tait-mx/Constelacion/Electronica/DFPlayer mp3/conexiones amazon.jpg

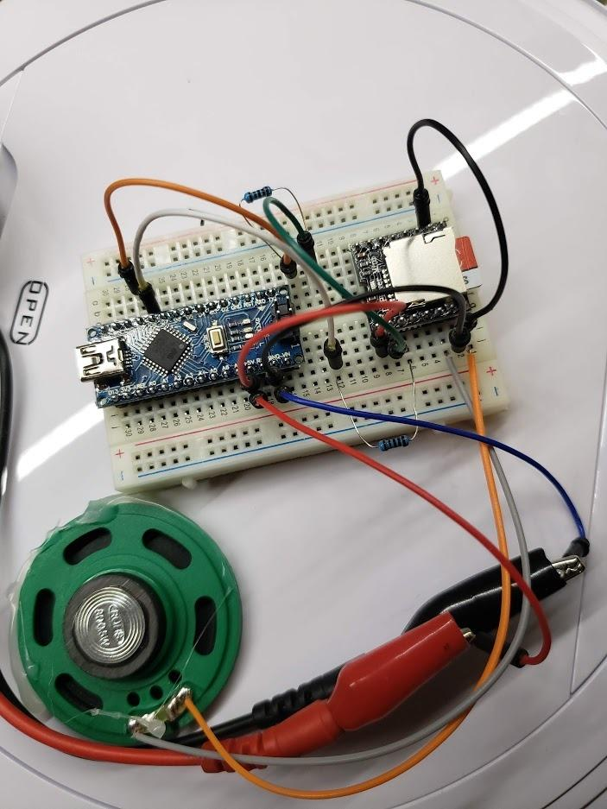
Electronica/DFPlayer mp3/conexiones amazon.jpg
