tait-mx/Constelacion/Electronica/DFPlayer mp3/Avoid Noise Add 10kohm to Tx Rx.png

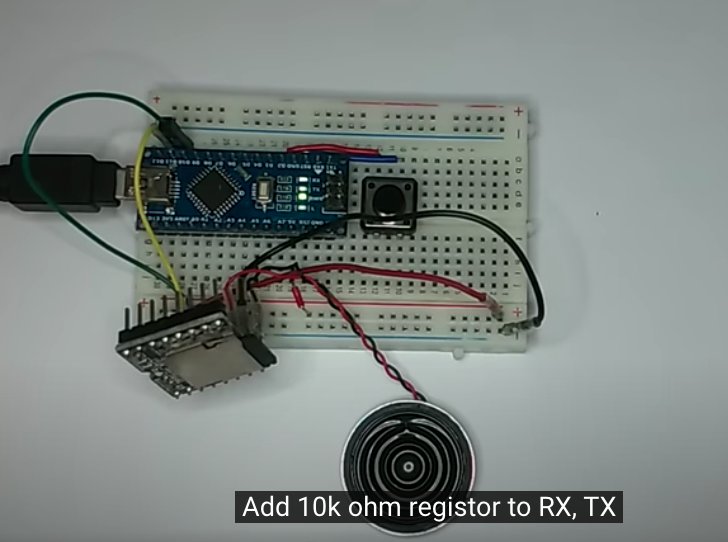
Electronica/DFPlayer mp3/Avoid Noise Add 10kohm to Tx Rx.png
