tait-mx/Constelacion/ESP32/ESP32-C3_SuperMini_macOS_HighSierra_solucion.docx

Solución: Programar ESP32-C3 Super Mini desde macOS 10.13.6 (High Sierra)

Guía de pasos seguidos para resolver la incompatibilidad entre Arduino IDE 1.8.16, el core ESP32 moderno y macOS High Sierra.

# Resumen del problema

La placa ESP32-C3 Super Mini requiere una versión reciente del paquete (core) de ESP32 para Arduino, pero las versiones recientes de ese paquete incluyen un ejecutable de "esptool" compilado únicamente para macOS 10.15 (Catalina) o superior. En macOS 10.13.6 esto provoca errores de compilación y carga ("Symbol not found: ____chkstk_darwin"). Este es un problema reconocido oficialmente por Espressif (issue #5639 en su repositorio de GitHub), marcado como "no se va a corregir" porque sus sistemas de compilación ya no soportan versiones antiguas de macOS.

# Pasos realizados

## 1. Identificar la placa y el pinout correcto

Se confirmó que la placa correspondía a la variante ESP32-C3 Super Mini (chip QFN32 5x5mm), distinta del ESP32 DevKit clásico (módulo WROOM). El LED integrado en esta placa está conectado al GPIO8 y funciona con lógica invertida (LOW = encendido, HIGH = apagado).

## 2. Actualizar el paquete de placas ESP32 en Arduino IDE

En Arduino > Preferences se verificó la URL adicional de gestor de placas:

https://raw.githubusercontent.com/espressif/arduino-esp32/gh-pages/package_esp32_index.json

Luego, desde Herramientas > Placa > Boards Manager, se actualizó el paquete "esp32" de Espressif Systems para que apareciera la opción "ESP32C3 Dev Module".

## 3. Resolver error de descarga corrupta (CRC doesn't match)

Al actualizar el paquete apareció un error de CRC por una descarga incompleta. Se solucionó borrando los archivos en caché dentro de:

~/Library/Arduino15/staging/packages

y reinstalando el paquete desde Boards Manager para forzar una descarga limpia.

## 4. Descartar Arduino IDE 2.x

Se confirmó que Arduino IDE 2.x requiere macOS 10.15 (Catalina) o superior, por lo que no es instalable en macOS 10.13.6. Se continuó trabajando con Arduino IDE 1.8.16, que sí es compatible.

## 5. Diagnosticar el error de Python/esptool

Al compilar para "ESP32C3 Dev Module" apareció el error:

Error loading Python lib '.../libpython3.8.dylib': ... Symbol not found: ____chkstk_darwin

Se identificó que este es un problema conocido y documentado (GitHub issue #5639 de espressif/arduino-esp32): el ejecutable "esptool" incluido en el paquete a partir de la versión 2.0.0 del core requiere macOS 10.15 o superior.

## 6. Instalar Python 3 y esptool

Se confirmó que la Mac ya tenía Python 3.7.5 instalado. Se instaló pyserial y, tras varios ajustes, se optó por una versión de esptool compatible con Python 3.7 sin dependencias pesadas (cryptography con Rust):

pip3 install --upgrade pip setuptools wheel

pip3 install pyserial "esptool==3.3.1"

Se verificó la instalación con:

esptool.py version → esptool.py v3.3.1

## 7. Editar platform.txt (primer intento — sufijo incorrecto)

Se localizó el archivo de configuración del core en:

~/Library/Arduino15/packages/esp32/hardware/esp32/<version>/platform.txt

Se agregó una línea para usar Python en lugar del binario roto, inicialmente con el sufijo "macos" (incorrecto):

tools.esptool_py.cmd.macos=python3 -m esptool

El error persistió porque Arduino usa el sufijo "macosx" (con "x"), no "macos", para identificar el sistema operativo.

## 8. Corregir el sufijo del sistema operativo

Se corrigió la línea a:

tools.esptool_py.cmd.macosx=python3 -m esptool

Sin embargo, surgió un nuevo error: Arduino concatena la ruta y el comando como una sola cadena ("{ruta}/{comando}"), por lo que no puede interpretar "python3 -m esptool" como programa + argumentos. El sistema intentaba ejecutar un archivo literal con ese texto completo como nombre, lo cual no existe.

## 9. Reemplazar el binario roto por un script wrapper

Se revirtió el cambio en platform.txt (para volver a usar el nombre genérico "esptool") y, en su lugar, se reemplazó el binario problemático directamente:

cd ~/Library/Arduino15/packages/esp32/tools/esptool_py/3.1.0/

mv esptool esptool.roto

printf '#!/bin/bash\nexec python3 -m esptool "$@"\n' > esptool

chmod +x esptool

## 10. Corregir la ruta de Python dentro del script

El script inicial falló porque Arduino ejecuta procesos con un PATH restringido que no incluye la carpeta de Python. Se obtuvo la ruta absoluta con:

which python3

y se editó el script para usar la ruta completa en lugar de solo "python3", por ejemplo:

exec /usr/local/bin/python3 -m esptool "$@"

## 11. Corregir el puerto serie (USB)

Tras lograr compilar exitosamente, apareció un error de puerto no encontrado (/dev/cu.SLAB_USBtoUART), causado por haber cambiado de entrada USB física. Se identificó el puerto correcto con:

ls /dev/cu.*

y se seleccionó el puerto adecuado en Herramientas > Puerto dentro de Arduino IDE.

## 12. Resultado final

Con todos los ajustes anteriores, el sketch Blink compiló y se cargó exitosamente en el ESP32-C3 Super Mini, confirmando el parpadeo del LED integrado (GPIO8).

# Resumen de archivos y cambios clave

- Paquete ESP32 actualizado vía Boards Manager en Arduino IDE 1.8.16.
- Python 3.7.5 + pyserial + esptool 3.3.1 instalados vía pip3.
- Binario original en tools/esptool_py/3.1.0/esptool respaldado como esptool.roto.
- Nuevo script esptool creado en esa misma carpeta, apuntando a la ruta absoluta de python3.
- Puerto USB verificado y seleccionado correctamente en Herramientas > Puerto.

# Notas para el futuro

1. Si se reinstala o actualiza el paquete ESP32, es probable que el binario "esptool" original vuelva a aparecer y haya que repetir el reemplazo por el script wrapper.
2. Si se cambia de puerto USB o de cable, verificar el puerto correcto con "ls /dev/cu.*" antes de subir un sketch.
3. Esta solución aplica en general a cualquier herramienta del core ESP32 que dependa de un binario compilado incompatible con macOS 10.13 (por ejemplo, versiones futuras de espota.py u otras herramientas), usando el mismo enfoque de script wrapper.
