tait-mx/Constelacion/Tlc5940NT/Funciones_JLCooper_ConstelacionTodos.rtf

(
~funcionControladorLEDsOn={
~led2=254;~led3=254;~led4=254;~led5=254;~led6=254;~led7=254;~led8=254;~led9=254;
~led10=254;~led11=254;~led12=254;~led13=254;~led14=254;~led15=254;~led16=254;~led17=254;
~led18=254;~led19=254;~led20=254;~led21=254;~led22=254;~led23=254;~led24=254;~led25=254;
~led26=254;~led27=254;~led28=254;~led29=254;~led30=254;~led31=254;~led32=254;~led33=254;}
);
/*
~funcionControladorLEDsOn.value
*/
(
~funcionControladorLEDsOff={
~led2=0;~led3=0;~led4=0;~led5=0;~led6=0;~led7=0;~led8=0;~led9=0;
~led10=0;~led11=0;~led12=0;~led13=0;~led14=0;~led15=0;~led16=0;~led17=0;
~led18=0;~led19=0;~led20=0;~led21=0;~led22=0;~led23=0;~led24=0;~led25=0;
~led26=0;~led27=0;~led28=0;~led29=0;~led30=0;~led31=0;~led32=0;~led33=0;}
);
/*
~funcionControladorLEDsOff.value
*/

// Motivos

~motivo132LEDswait=1;
~motivo232LEDswait=1;
~motivo332LEDswait=1;
~motivo432LEDswait=1;

// Motivo 1

(
Tdef(\motivo132LEDs, {~rrandmotivo132LEDs=rrand(2,10);
~motivo132LEDs=(Array.rand(~rrandmotivo132LEDs, 0, 7)++(5000!rrand(2,5))).scramble;
~durmotivo132LEDs=Array.rand(~motivo132LEDs.size, 0.2, 2);
inf.do{|i|
switch((~motivo132LEDs[i%~motivo132LEDs.size]),
0, {~led2=254;~led3=254;~led4=254;~led5=254;},
1, {~led6=254;~led7=254;~led8=254;~led9=254;},
2, {~led10=254;~led11=254;~led12=254;~led13=254;},
3, {~led14=254;~led15=254;~led16=254;~led17=254;},
4, {~led18=254;~led19=254;~led20=254;~led21=254;},
5, {~led22=254;~led23=254;~led24=254;~led25=254;},
6, {~led26=254;~led27=254;~led28=254;~led29=254;},
7, {~led30=254;~led31=254;~led32=254;~led33=254;},
5000, {~led2=0;~led3=0;~led4=0;~led5=0;~led6=0;~led7=0;~led8=0;~led9=0;
~led10=0;~led11=0;~led12=0;~led13=0;~led14=0;~led15=0;~led16=0;~led17=0;
~led18=0;~led19=0;~led20=0;~led21=0;~led22=0;~led23=0;~led24=0;~led25=0;
~led26=0;~led27=0;~led28=0;~led29=0;~led30=0;~led31=0;~led32=0;~led33=0;}
);
(~durmotivo132LEDs[i%~motivo132LEDs.size]*~motivo132LEDswait).wait;
~led2=0;~led3=0;~led4=0;~led5=0;~led6=0;~led7=0;~led8=0;~led9=0;
~led10=0;~led11=0;~led12=0;~led13=0;~led14=0;~led15=0;~led16=0;~led17=0;
~led18=0;~led19=0;~led20=0;~led21=0;~led22=0;~led23=0;~led24=0;~led25=0;
~led26=0;~led27=0;~led28=0;~led29=0;~led30=0;~led31=0;~led32=0;~led33=0;
}})
);
/*
Tdef(\motivo132LEDs).play;
Tdef(\motivo132LEDs).stop
*/

// Motivo 2

(
Tdef(\motivo232LEDs, {~rrandmotivo232LEDs=rrand(2,10);
~motivo232LEDs=(Array.rand(~rrandmotivo232LEDs, 0, 7)++(5000!rrand(2,5))).scramble;
~durmotivo232LEDs=Array.rand(~motivo232LEDs.size, 0.2, 2);
inf.do{|i|
switch((~motivo232LEDs[i%~motivo232LEDs.size]).postln,
0, {~led2=254;~led3=254;~led4=254;~led5=254;},
1, {~led6=254;~led7=254;~led8=254;~led9=254;},
2, {~led10=254;~led11=254;~led12=254;~led13=254;},
3, {~led14=254;~led15=254;~led16=254;~led17=254;},
4, {~led18=254;~led19=254;~led20=254;~led21=254;},
5, {~led22=254;~led23=254;~led24=254;~led25=254;},
6, {~led26=254;~led27=254;~led28=254;~led29=254;},
7, {~led30=254;~led31=254;~led32=254;~led33=254;},
5000, {~led2=0;~led3=0;~led4=0;~led5=0;~led6=0;~led7=0;~led8=0;~led9=0;
~led10=0;~led11=0;~led12=0;~led13=0;~led14=0;~led15=0;~led16=0;~led17=0;
~led18=0;~led19=0;~led20=0;~led21=0;~led22=0;~led23=0;~led24=0;~led25=0;
~led26=0;~led27=0;~led28=0;~led29=0;~led30=0;~led31=0;~led32=0;~led33=0;}
);
(~durmotivo232LEDs[i%~motivo232LEDs.size]*~motivo232LEDswait).wait;
"PAUSA".postln;
~led2=0;~led3=0;~led4=0;~led5=0;~led6=0;~led7=0;~led8=0;~led9=0;
~led10=0;~led11=0;~led12=0;~led13=0;~led14=0;~led15=0;~led16=0;~led17=0;
~led18=0;~led19=0;~led20=0;~led21=0;~led22=0;~led23=0;~led24=0;~led25=0;
~led26=0;~led27=0;~led28=0;~led29=0;~led30=0;~led31=0;~led32=0;~led33=0;
}})
);
/*
Tdef(\motivo232LEDs).play;
Tdef(\motivo232LEDs).stop
*/

// Motivo 3

(
Tdef(\motivo332LEDs, {~rrandmotivo332LEDs=rrand(2,10);
~motivo332LEDs=(Array.rand(~rrandmotivo332LEDs, 0, 7)++(5000!rrand(2,5))).scramble;
~durmotivo332LEDs=Array.rand(~motivo332LEDs.size, 0.2, 2);
inf.do{|i|
switch((~motivo332LEDs[i%~motivo332LEDs.size]),
0, {~led2=254;~led3=254;~led4=254;~led5=254;},
1, {~led6=254;~led7=254;~led8=254;~led9=254;},
2, {~led10=254;~led11=254;~led12=254;~led13=254;},
3, {~led14=254;~led15=254;~led16=254;~led17=254;},
4, {~led18=254;~led19=254;~led20=254;~led21=254;},
5, {~led22=254;~led23=254;~led24=254;~led25=254;},
6, {~led26=254;~led27=254;~led28=254;~led29=254;},
7, {~led30=254;~led31=254;~led32=254;~led33=254;},
5000, {~led2=0;~led3=0;~led4=0;~led5=0;~led6=0;~led7=0;~led8=0;~led9=0;
~led10=0;~led11=0;~led12=0;~led13=0;~led14=0;~led15=0;~led16=0;~led17=0;
~led18=0;~led19=0;~led20=0;~led21=0;~led22=0;~led23=0;~led24=0;~led25=0;
~led26=0;~led27=0;~led28=0;~led29=0;~led30=0;~led31=0;~led32=0;~led33=0;}
);
(~durmotivo332LEDs[i%~motivo332LEDs.size]*~motivo332LEDswait).wait;
~led2=0;~led3=0;~led4=0;~led5=0;~led6=0;~led7=0;~led8=0;~led9=0;
~led10=0;~led11=0;~led12=0;~led13=0;~led14=0;~led15=0;~led16=0;~led17=0;
~led18=0;~led19=0;~led20=0;~led21=0;~led22=0;~led23=0;~led24=0;~led25=0;
~led26=0;~led27=0;~led28=0;~led29=0;~led30=0;~led31=0;~led32=0;~led33=0;
}})
);
/*
Tdef(\motivo332LEDs).play;
Tdef(\motivo332LEDs).stop
*/

// Motivo 4

(
Tdef(\motivo432LEDs, {~rrandmotivo432LEDs=rrand(2,10);
~motivo432LEDs=(Array.rand(~rrandmotivo432LEDs, 0, 7)++(5000!rrand(2,5))).scramble;
~durmotivo432LEDs=Array.rand(~motivo432LEDs.size, 0.2, 2);
inf.do{|i|
switch((~motivo432LEDs[i%~motivo432LEDs.size]),
0, {~led2=254;~led3=254;~led4=254;~led5=254;},
1, {~led6=254;~led7=254;~led8=254;~led9=254;},
2, {~led10=254;~led11=254;~led12=254;~led13=254;},
3, {~led14=254;~led15=254;~led16=254;~led17=254;},
4, {~led18=254;~led19=254;~led20=254;~led21=254;},
5, {~led22=254;~led23=254;~led24=254;~led25=254;},
6, {~led26=254;~led27=254;~led28=254;~led29=254;},
7, {~led30=254;~led31=254;~led32=254;~led33=254;},
5000, {~led2=0;~led3=0;~led4=0;~led5=0;~led6=0;~led7=0;~led8=0;~led9=0;
~led10=0;~led11=0;~led12=0;~led13=0;~led14=0;~led15=0;~led16=0;~led17=0;
~led18=0;~led19=0;~led20=0;~led21=0;~led22=0;~led23=0;~led24=0;~led25=0;
~led26=0;~led27=0;~led28=0;~led29=0;~led30=0;~led31=0;~led32=0;~led33=0;}
);
(~durmotivo432LEDs[i%~motivo432LEDs.size]*~motivo432LEDswait).wait;
~led2=0;~led3=0;~led4=0;~led5=0;~led6=0;~led7=0;~led8=0;~led9=0;
~led10=0;~led11=0;~led12=0;~led13=0;~led14=0;~led15=0;~led16=0;~led17=0;
~led18=0;~led19=0;~led20=0;~led21=0;~led22=0;~led23=0;~led24=0;~led25=0;
~led26=0;~led27=0;~led28=0;~led29=0;~led30=0;~led31=0;~led32=0;~led33=0;
}})
);
/*
Tdef(\motivo432LEDs).play;
Tdef(\motivo432LEDs).stop
*/
