tait-mx/Constelacion/Tlc5940NT/LED_SC3_Alfa_Tlc_32.rtf

/*
Aqui se conecta el SuperCollider con el puerto Serial e inicia la rutina de lectura
(
~led_SC3_Alfa_Tlc_32= SerialPort("/dev/tty.usbserial-A7005ZIA",9600,crtscts: true);
Tdef(\alfa_Tlc_32).play;
)
Aqui se desconecta el SuperCollider del puerto Serial y detiene la rutina de lectura
(
Tdef(\alfa_Tlc_32).stop;
~led_SC3_Alfa_Tlc_32.close;
)

~waitAlfaTLC=0.005;

~fTodosLEDsOn.value;
~fTodosLEDsOff.value;

Aqui se asigna el valor de máxima intensiad a los LEDs, 254
(
~fTodosLEDsOn={
~led2=254;
~led3=254;
~led4=254;
~led5=254;
~led6=254;
~led7=254;
~led8=254;
~led9=254;
~led10=254;
~led11=254;
~led12=254;
~led13=254;
~led14=254;
~led15=254;
~led16=254;
~led17=254;

~led18=254;
~led19=254;
~led20=254;
~led21=254;
~led22=254;
~led23=254;
~led24=254;
~led25=254;
~led26=254;
~led27=254;
~led28=254;
~led29=254;
~led30=254;
~led31=254;
~led32=254;
~led33=254;
};
~fTodosLEDsOn.value;
)

Aqui se asigna un valor aleatorio entre el mínimo y el máximo de intensiad a los LEDs
(
~led2=[0,254].choose;
~led3=[0,254].choose;
~led4=[0,254].choose;
~led5=[0,254].choose;
~led6=[0,254].choose;
~led7=[0,254].choose;
~led8=[0,254].choose;
~led9=[0,254].choose;
~led10=[0,254].choose;
~led11=[0,254].choose;
~led12=[0,254].choose;
~led13=[0,254].choose;
~led14=[0,254].choose;
~led15=[0,254].choose;
~led16=[0,254].choose;
~led17=[0,254].choose;

~led18=[0,254].choose;
~led19=[0,254].choose;
~led20=[0,254].choose;
~led21=[0,254].choose;
~led22=[0,254].choose;
~led23=[0,254].choose;
~led24=[0,254].choose;
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
~led_SC3_Alfa_Tlc_32.put(~led29);~waitAlfaTLC.wait;
~led_SC3_Alfa_Tlc_32.put(~led30);~waitAlfaTLC.wait;
~led_SC3_Alfa_Tlc_32.put(~led31);~waitAlfaTLC.wait;
~led_SC3_Alfa_Tlc_32.put(~led32);~waitAlfaTLC.wait;
~led_SC3_Alfa_Tlc_32.put(~led33);~waitAlfaTLC.wait;

}
}).quant_(0);
);
