tait-mx/Constelacion/Electronica/LCD1602/LCD1602_con_Arduino.pdf

# Interfaz de LCD1602 con Arduino

Tutorial original: Najad (DIY Usthad) — Arduino Project Hub create.arduino.cc/projecthub/najad/interfacing-lcd1602-with-arduino-764ec4

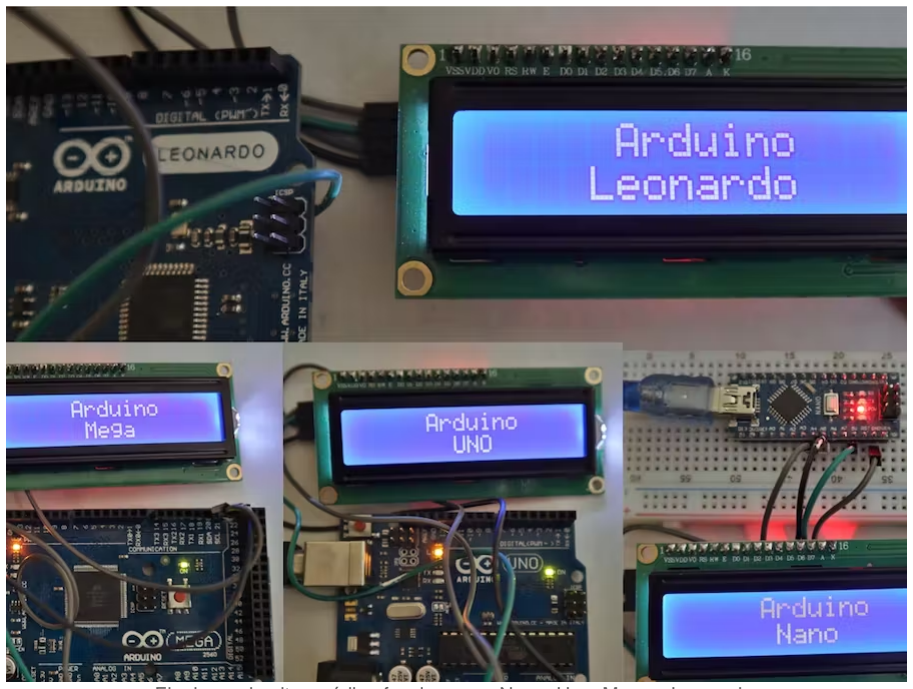
[picture p3: figure]

El mismo circuito y código funcionan en Nano, Uno, Mega y Leonardo.

## Introducción

Este tutorial muestra cómo conectar un módulo LCD 16x2 a varias placas de Arduino (Nano, Uno, Mega, Leonardo) usando el modo de datos de 4 bits.

## Hardware usado

- Módulo LCD 16x2
- Arduino UNO / Nano / Leonardo / Mega (cualquiera de estas)

## Software y librería

- Arduino IDE
- Librería LiquidCrystal (incluida por default en el IDE)

## Sobre los módulos LCD

Existen módulos LCD de distintos tamaños. El más común es el LCD1602, que muestra 16 caracteres por línea en 2 líneas (32 caracteres en total):

Modelo | Caracteres / línea | Líneas

LCD1601 | 16 | 1
LCD1602 | 16 | 2
LCD1604 | 16 | 4
LCD2004 | 20 | 4

## Descripción de pines del LCD

Pin # | Nombre | Descripción
1 | VSS (0V) | Tierra (ground)
2 | VDD (5V) | Voltaje positivo
3 | V0 (Contraste) | Ajuste de contraste; 0V = contraste máx., 5V = contraste mín.
4 | RS | Selección de registro (0 = instrucciones, 1 = datos)
5 | RW | Lectura/escritura (0 = escritura, 1 = lectura)
6 | E | Habilitación (enable) del módulo
7–14 | D0–D7 | Bus de datos (transferencia paralela)
15 | LED+ (A) | Ánodo del LED de retroiluminación
16 | LCD- (K) | Cátodo del LED de retroiluminación

## Conexiones (circuito)

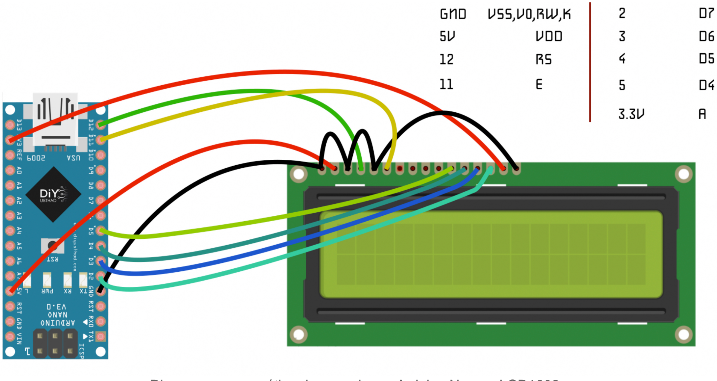
[picture p4: figure]

Diagrama esquemático de conexiones Arduino Nano – LCD1602.

# | Arduino | LCD1602

1 | GND | VSS, V0, RW, K
2 | 5V | VDD
3 | Pin digital 12 | RS
4 | Pin digital 11 | E
5 | Pin digital 5 | D4
6 | Pin digital 4 | D5
7 | Pin digital 3 | D6
8 | Pin digital 2 | D7
9 | 3.3V | A (ánodo retroiluminación)

Nota de la comunidad (comentarios del tutorial): varios usuarios reportaron ver solo bloques blancos en vez de texto. La causa casi siempre es el contraste (pin V0). Recomiendan usar un potenciómetro (trimmer) de 10k o una resistencia de ~2k en V0 en vez de conectarlo directo a GND, ya que el rango entre "bloques blancos" y "sin nada" es muy angosto. Un usuario también mencionó que cambiar los pines RS/E de 12/11 a otros pines libres (ej. 4/5) le resolvió el problema — si a ti no te funciona con 12/11, prueba con otros pines digitales.

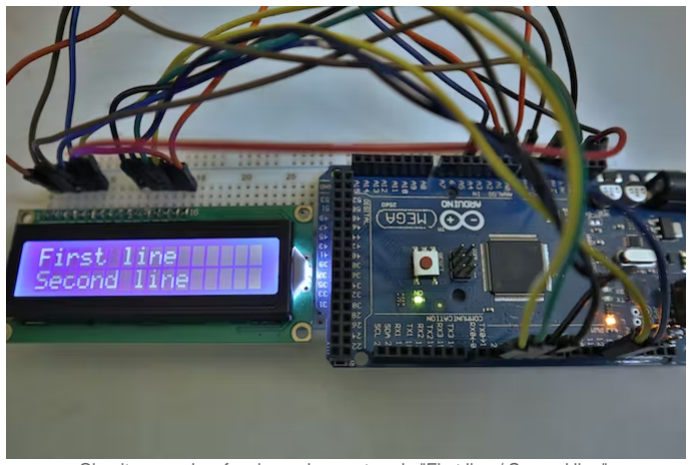
[picture p5: figure]

Circuito armado y funcionando, mostrando "First line / Second line".

## Código

#include <LiquidCrystal.h>

const int rs = 12, en = 11, d4 = 5, d5 = 4, d6 = 3, d7 = 2; LiquidCrystal lcd(rs, en, d4, d5, d6, d7);

void setup() {
lcd.begin(16, 2);
lcd.print("First line");
lcd.setCursor(0, 1);
lcd.print("Second line");
}

void loop() {
}

Publicado el 13 de junio de 2019, por Najad (DIY Usthad).
