tait-mx/Constelacion/Tlc5940NT/Conexión Arduino Mega - Tlc5490NT.pdf

## Conexión Arduino Mega - Tlc5490NT

| Tlc5490NT | Arduino Mega
| FUNCIÓN | PIN | FUNCIÓN | PIN
1 | GSCLK | 18 | DIGITAL | 9
2 | DCPRG | 19 | 5v | 5v 1
3 | IREF | 20 | GND | (R2 2K) - GND3
4 | VCC | 21 | 5v | 5v 1
5 | GND | 22 | GND | GND3
6 | BLANK | 23 | 5v | (R1 10K) - 5v 1
7 | XLAT | 24 | DIGITAL | 11
8 | SCLK | 25 | DIGITAL | 52
9 | SIN | 26 | DIGITAL | 51
10 | VPROG | 27 | GND3 | GND3
