tait-mx/Constelacion/Lista de Villancicos.odt

La Constelación

Lista de Villancicos

1. Noche de Paz
2. El Niño del Tambor
3. Joy to the World
4. Campana sobre Campana
5. Jingle Bells
6. We Wish You a Merry Christmas
