tait-mx/Constelacion/Electronica/DFPlayer mp3/DFPlayer mini conexion Arduino.png

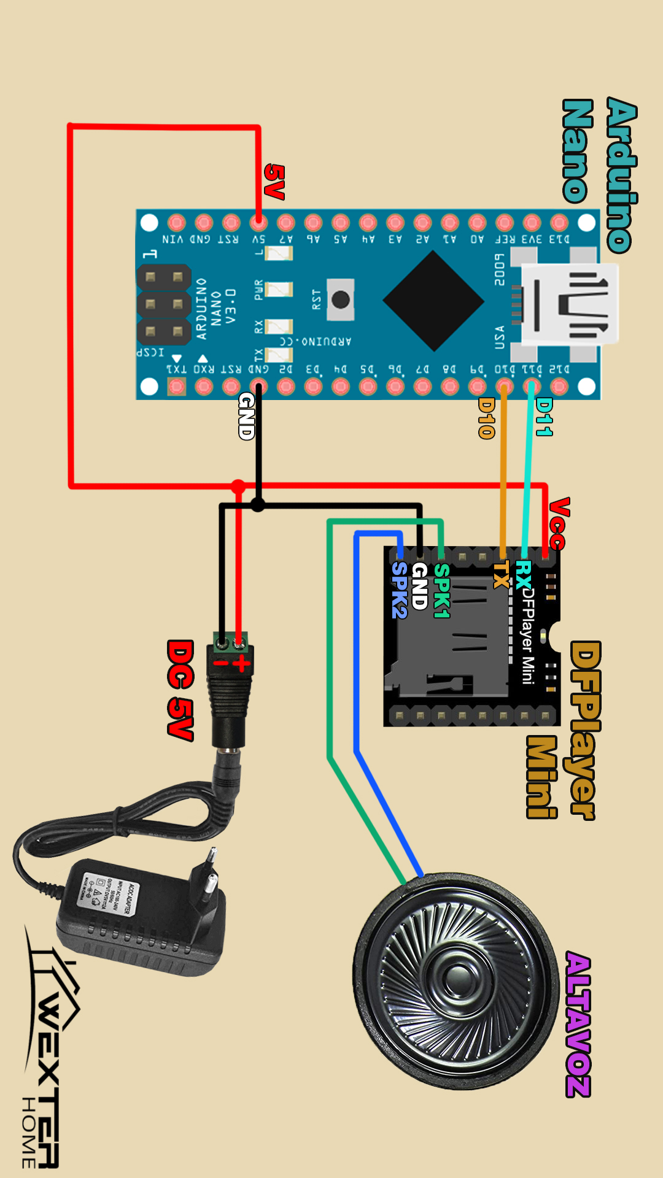
Electronica/DFPlayer mp3/DFPlayer mini conexion Arduino.png
