tait-mx/Constelacion/Electronica/LCD1602/Conexion-Arduino-LCD1602-13-12.PNG

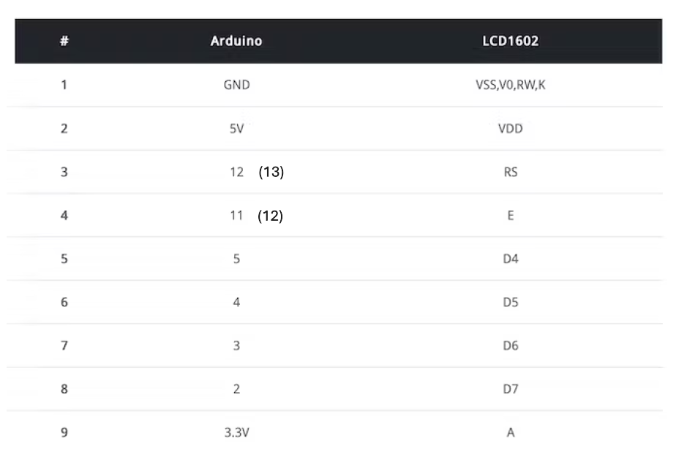
Electronica/LCD1602/Conexion-Arduino-LCD1602-13-12.PNG
