tait-mx/Constelacion/Electronica/LCD1602/Diagrama-Conexion-Arduino-LCD1602.png

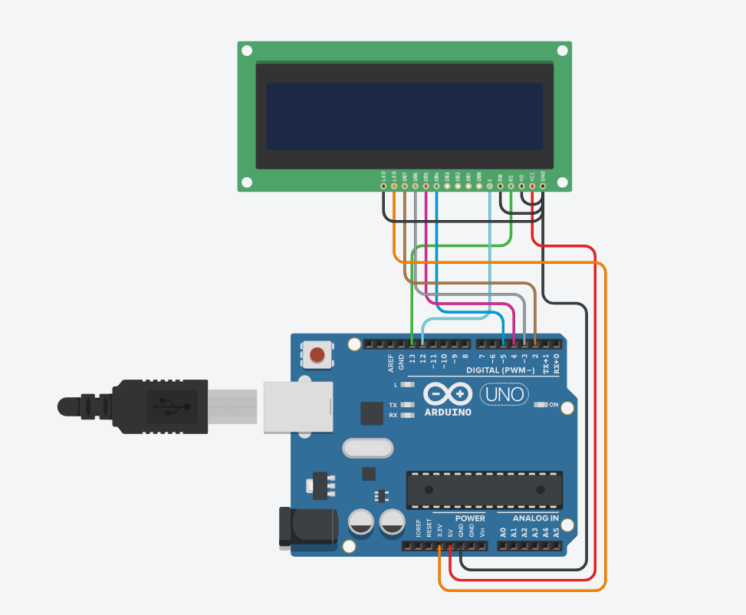
Electronica/LCD1602/Diagrama-Conexion-Arduino-LCD1602.png
