tait-mx/Constelacion/Electronica/LCD1602/lcd_Auz85fk0XB.jpg

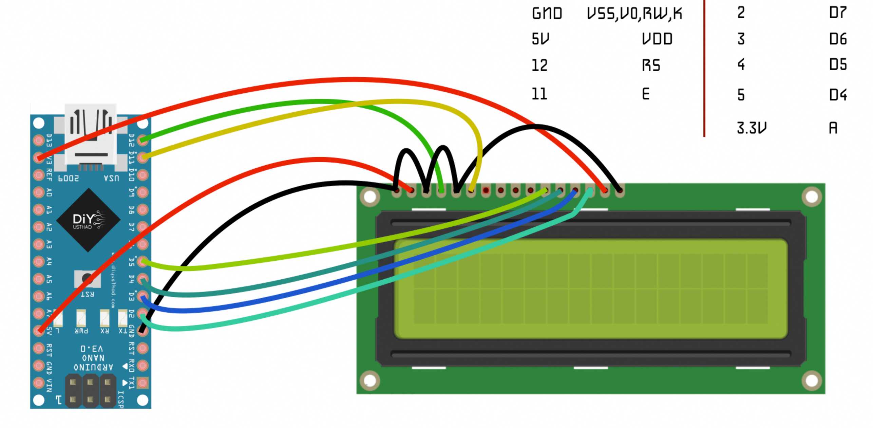
Electronica/LCD1602/lcd_Auz85fk0XB.jpg
