tait-mx/Constelacion/Electronica/Tlc5490NT/TLC_Arduino/breadboard-arduino-tlc5940_close.png

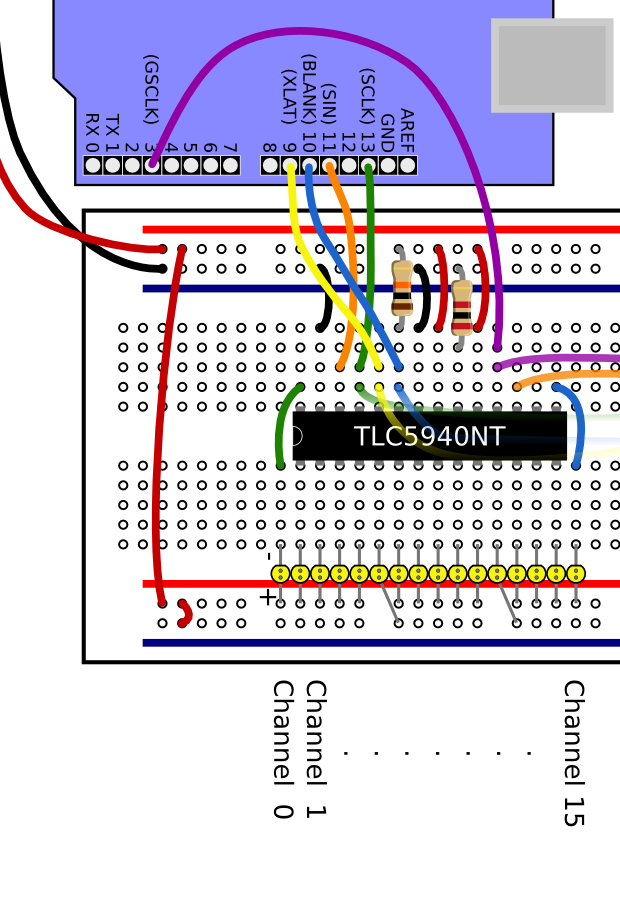
Electronica/Tlc5490NT/TLC_Arduino/breadboard-arduino-tlc5940_close.png
