tait-mx/Constelacion/ESP32/Conexion-inalambrica-ESP32-ESP32C/TP-link-Access-Point/Router_tp-link_Archer_AX11800/Router_tp-link_Archer_AX11800.jpeg

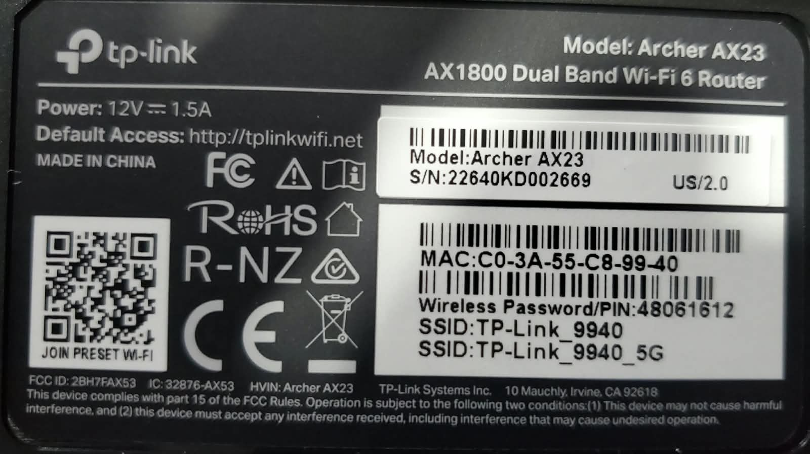
ESP32/Conexion-inalambrica-ESP32-ESP32C/TP-link-Access-Point/Router_tp-link_Archer_AX11800/Router_tp-link_Archer_AX11800.jpeg
