tait-mx/Constelacion/Estrella.png

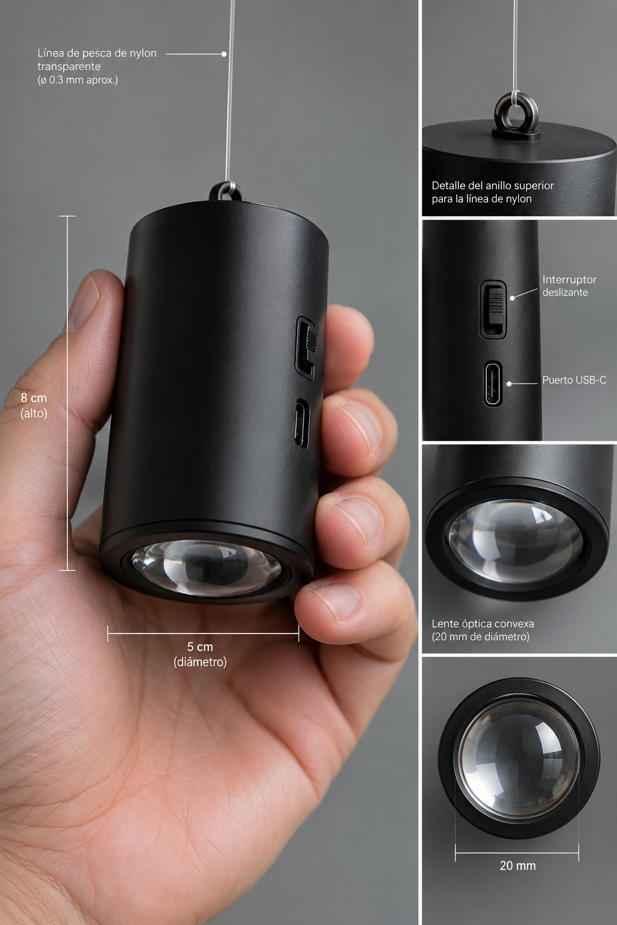
Estrella.png
