tait-mx/Constelacion/Gabinete_maestro.png

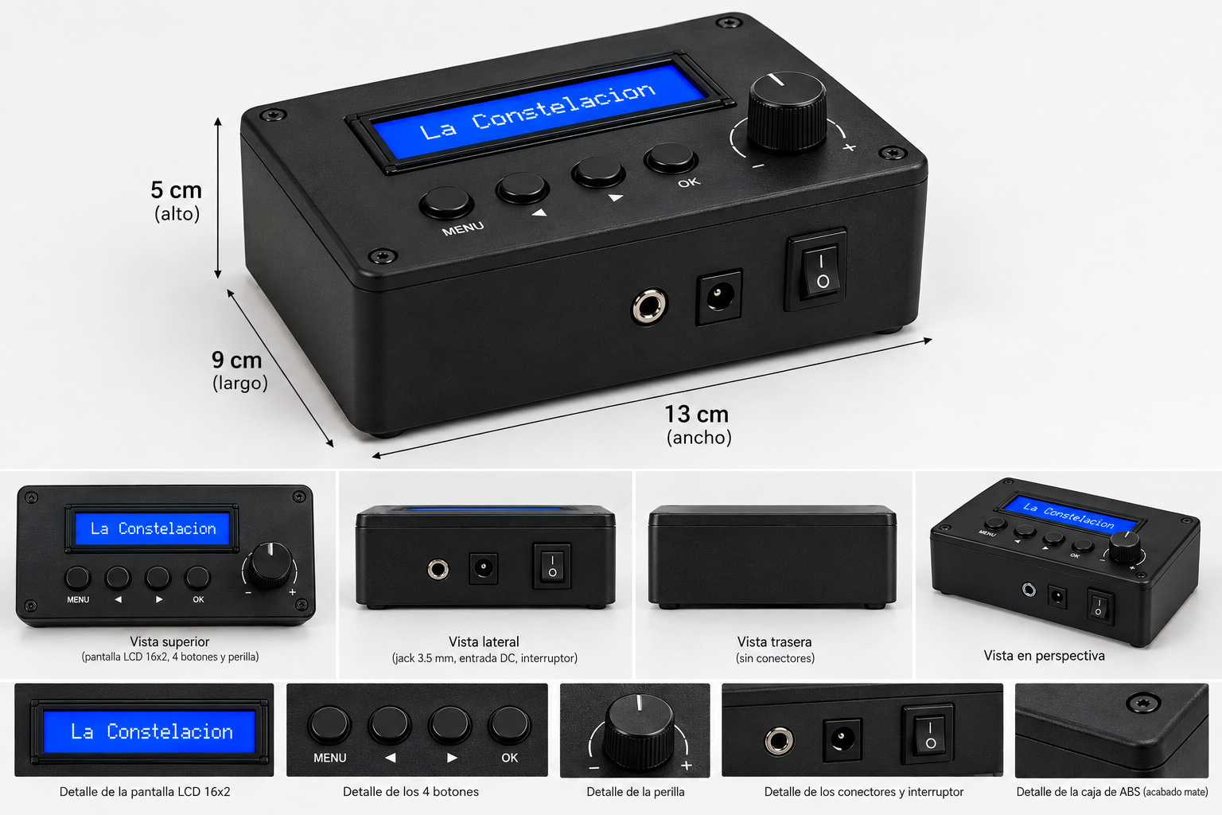
Gabinete_maestro.png
