tait-mx/Constelacion/Personas_usando_La_Constelacion.png

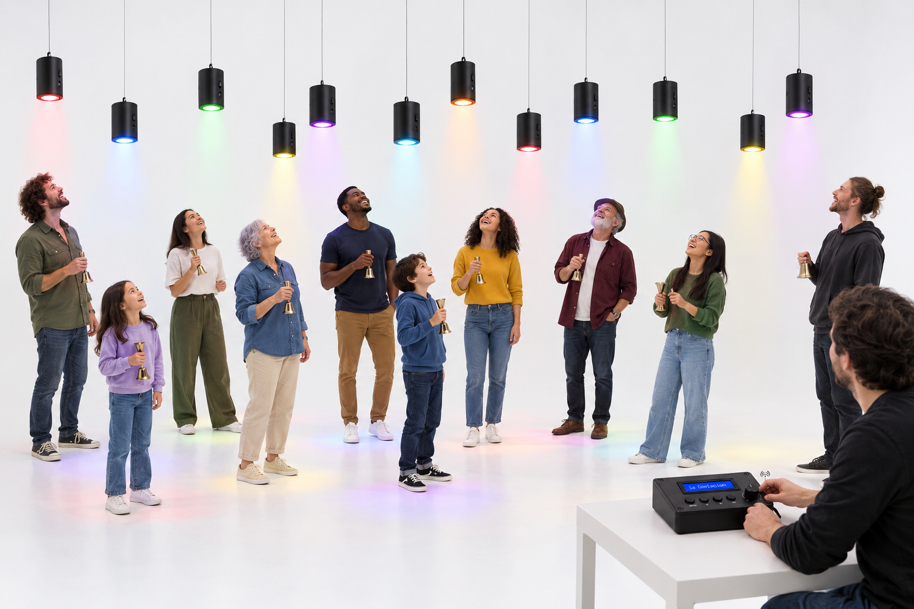
Personas_usando_La_Constelacion.png
