tait-mx/Constelacion/Villancicos/Joy-to-the-World.logicx/Alternatives/000/WindowImage.jpg

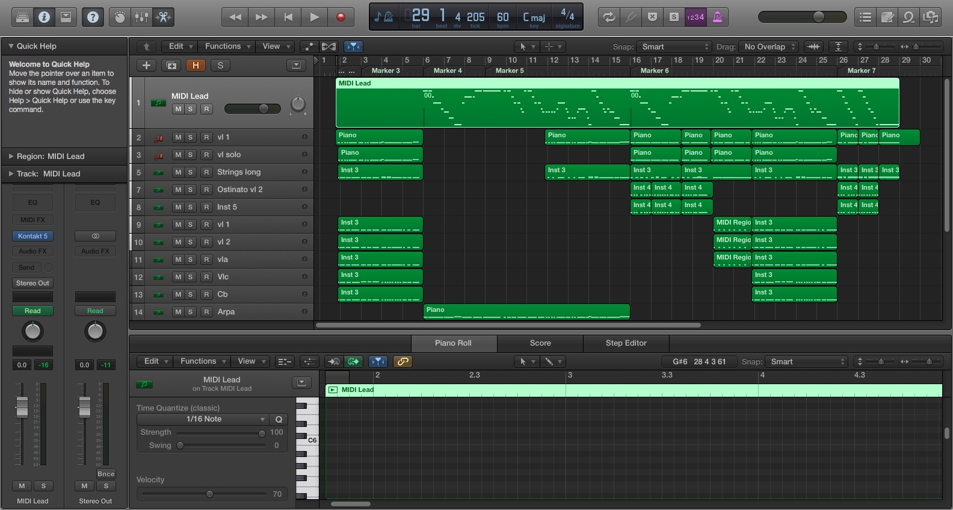
Villancicos/Joy-to-the-World.logicx/Alternatives/000/WindowImage.jpg
