tait-mx/Constelacion/Presupuesto_Materiales_Sistema_LED.xlsx

PRESUPUESTO DE MATERIALES - SISTEMA DE LEDS
Comparativa de costos: Sistema de 12 LEDs vs. Sistema de 24 LEDs
Opción 1: Sistema con 12 LEDs Independientes
Componente / Descripción | Cantidad | Precio Unitario (MXN) | Subtotal (MXN)
Placa ESP32 central (Emisor) | 1 | $150.00
Módulo DFPlayer Mini (Audio) | 1 | $40.00
Gabinete de control (Gabinete, 4 botones, LCD 16x2, Fuente Hi-Link 5V/1A, Switch ON/OFF) | 1 | $350.00
Cable de alimentación de CA para gabinete (Estándar tipo PC) | 1 | $80.00
Módulos de LED independientes (ESP32-C3 Mini, LED SK6812, Batería, TP4056, Regulador) | 12 | $160.00
COSTO TOTAL ESTIMADO
Opción 2: Sistema con 24 LEDs Independientes
Componente / Descripción | Cantidad | Precio Unitario (MXN) | Subtotal (MXN)
Placa ESP32 central (Emisor) | 1 | $150.00
Módulo DFPlayer Mini (Audio) | 1 | $40.00
Gabinete de control (Gabinete, 4 botones, LCD 16x2, Fuente Hi-Link 5V/1A, Switch ON/OFF) | 1 | $350.00
Cable de alimentación de CA para gabinete (Estándar tipo PC) | 1 | $80.00
Módulos de LED independientes (ESP32-C3 Mini, LED SK6812, Batería, TP4056, Regulador) | 24 | $160.00
COSTO TOTAL ESTIMADO
Notas y Escalabilidad:
• Hardware del Gabinete: No requiere modificaciones físicas al agregar o quitar módulos de LED.
• Firmware / Código: Al escalar de 12 a 24 LEDs, únicamente se debe actualizar el código de la placa ESP32 emisor.
• Precios estimados en pesos mexicanos (MXN) sujetos a variación por proveedor.
