tait-mx/Constelacion/Costo Materiales Constelacion inalambrica.xlsx

Proyecto "La Constelación"
Creador Ernesto Romero Mariscal Guasp
Guadalajara 2026
Descripción |  | Clientes potenciales
Instalación de luces controladas inalámbricamente para facilitar al público a participar acompañando música con campanas afinadas de manera sincronizada |  | - Centros comerciales - Bodas - Eventos culturales - Escuelas
Materiales
Módulo emisor
Descripción | Cantidad | Unidad | Precio Unitario | Precio | Proveedor
Placa ESP32 central (Emisor) | 1 | pieza | $129.99 | $129.99 | Mercado Libre (https://www.mercadolibre.com.mx/p/MLM2038887439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)
Módulo Reductor Voltaje Mp1584 Salida Fija 5v 3a | 1 | lote de 2 piezas | $174.00 | $174.00 | Mercado Libre (https://www.mercadolibre.com.mx/up/MLMU3464907216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)
TOTAL |  | 1 emisor | $303.99
Módulo receptor
Descripción | Cantidad | Unidad | Precio Unitario | Precio | Proveedor
ESP32-C3 Mini | 1 | lote de 2 pz | $174.52 | $174.52 | Mercado Libre (https://articulo.mercadolibre.com.mx/MLM-2502702301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)
Batería recargable de litio 3.7V | 2 | pieza | $178.60 | $357.20 | Mercado Libre (https://www.mercadolibre.com.mx/up/MLMU3896551627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)
Transistor de pequeña señal NPN, TO-206AA | 1 | lote de 10 pz | $180.00 | $180.00 | Steren (https://www.steren.com.mx/transistor-de-peque-a-se-al-npn-to-206aa.html)
TOTAL |  | 2 receptores | $711.72
Elementos Auxiliares
Protoboard 830 Puntos | 1 | lote de 3 piezas | $102.24 | $102.24 | Mercado Libre (https://www.mercadolibre.com.mx/p/MLM37728460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)
PRECIO AISLADO POR MÓDULO EMISOR | $216.99
PRECIO AISLADO POR MÓDULO RECEPTOR | $281.82
Producto obtenido en esta 1ra fase:
Un sistema básico para hacer pruebas de control de dos módulos de luz de forma inalámbrica
Elementos del sistema
Un módulo Emisor Wifi / bluetooth con alimentación de regulador de 12vcc y convertidor a 5vcc
Dos módulos receptores Wifi / bluetooth con alimentación de batería racargable
 |  |  | TOTAL | $1117.95
Producto planeado para una 2da fase:
Gabinete de mando para controlar inalámbricamente 12 módulos de luz y reproducción de música de forma controlada
