tait-mx/Constelacion/Electronica/Arduino_Mega-Tlc-DFPlayer-LCD1620.pdf

# 25SCLK - 50 ²⁵SCLK ⁻ ⁵⁰

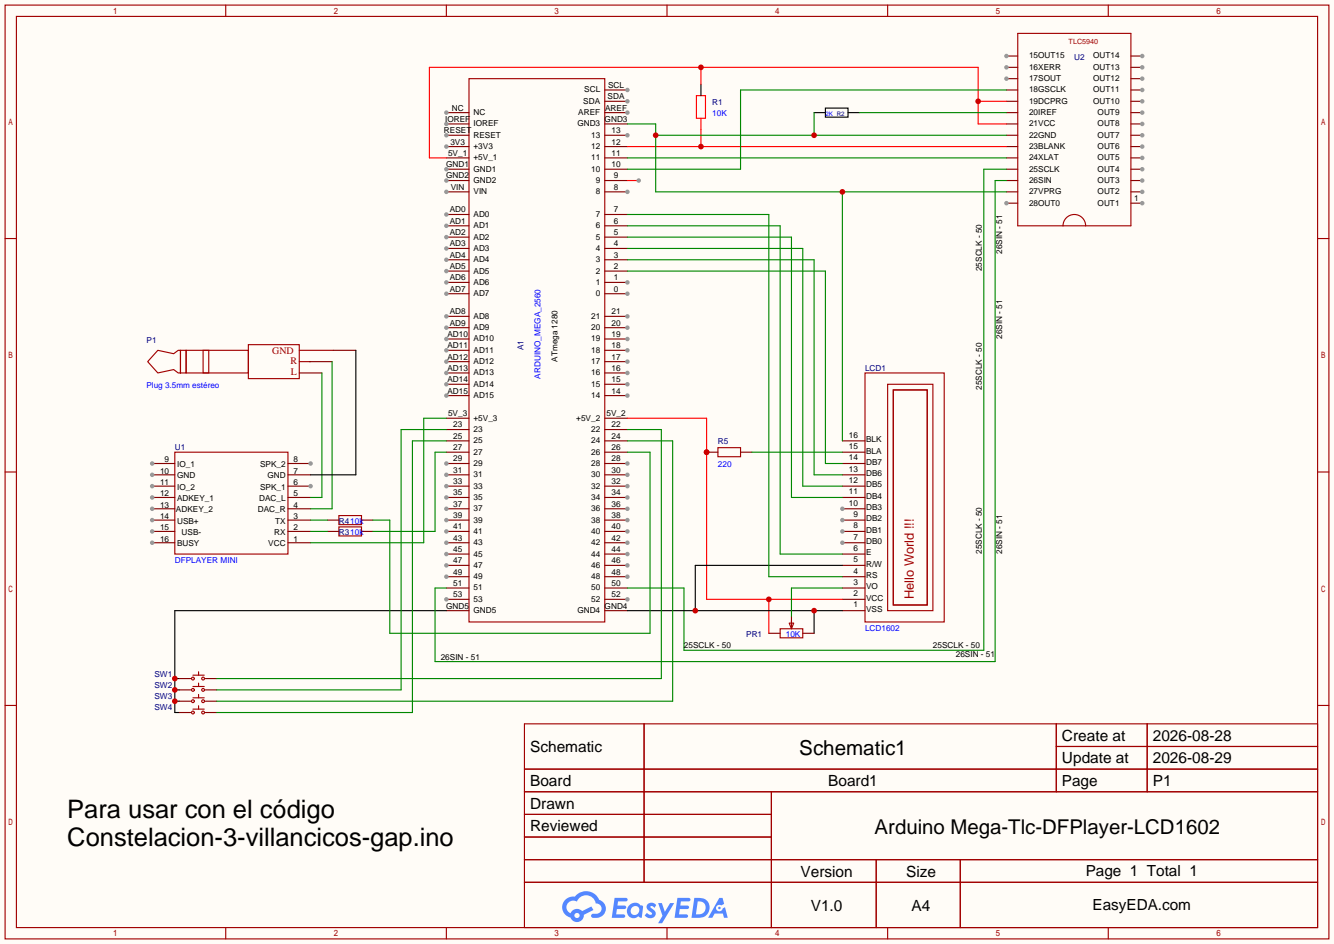
[picture p20: page 1]

Schematic | Schematic1 | Create at | 2026-08-28

Update at | 2026-08-29

Board | Board1 | Page | P1
Drawn | | Arduino Mega-Tlc-DFPlayer-LCD1602
Reviewed

Para usar con el código
Constelacion-3-villancicos-gap.ino

Version | Size | Page 1 Total 1
V1.0 | A4 | EasyEDA.com
