tait-mx/Constelacion/Electronica/Arduino Mega-Tlc-DFPlayer.pdf

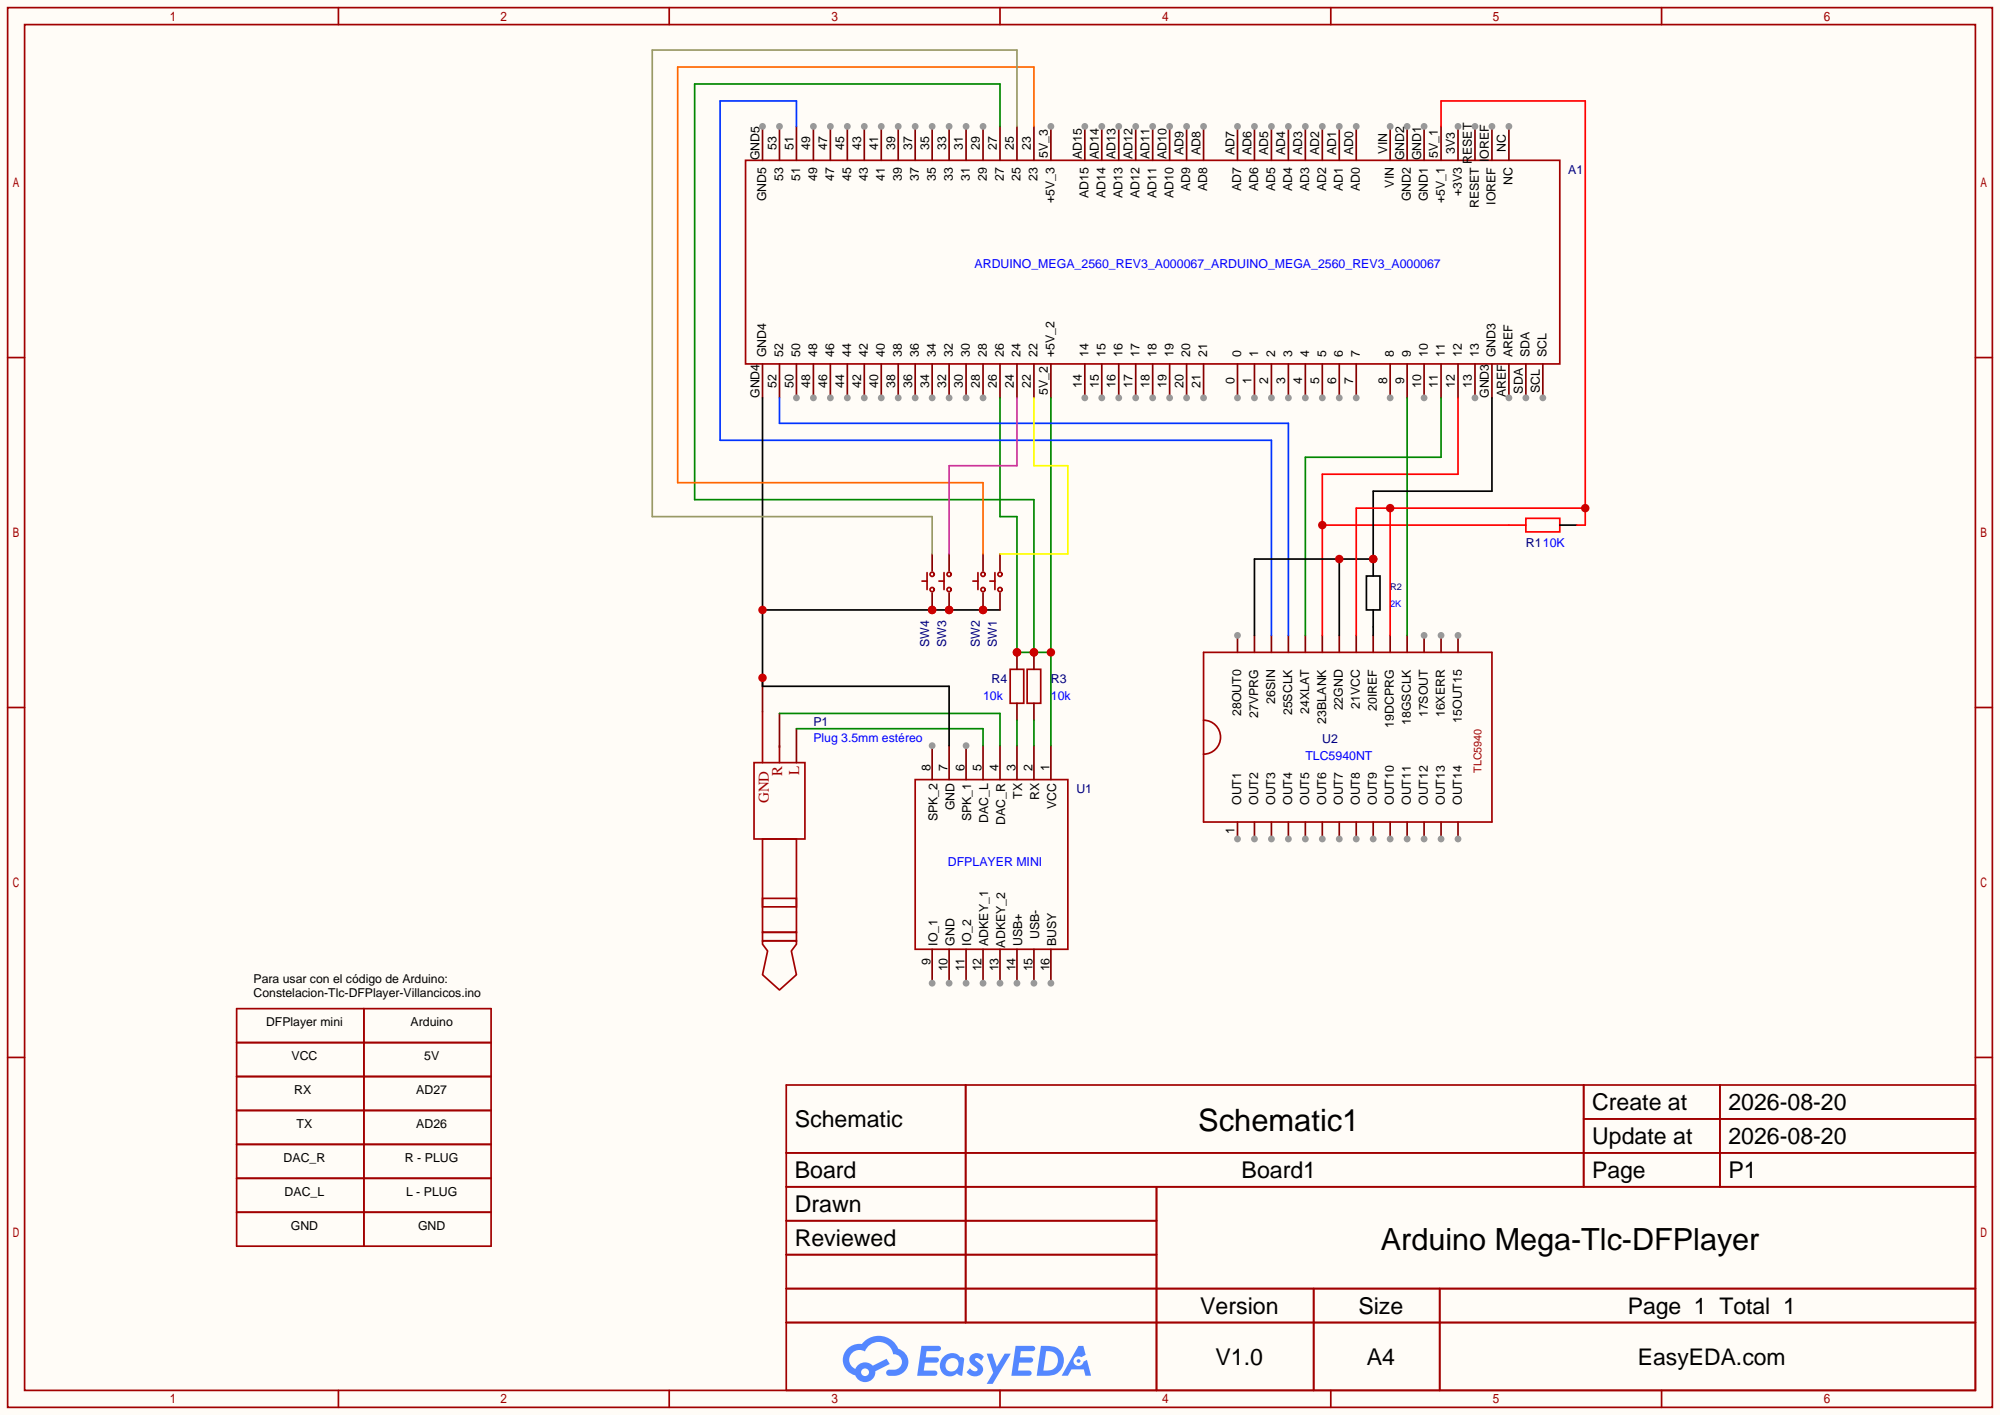
[picture p21: page 1]

Para usar con el código de Arduino:
Constelacion-Tlc-DFPlayer-Villancicos.ino

DFPlayer mini | Arduino

VCC | 5V

Schematic | Schematic1 | Create at | 2026-08-20

Update at | 2026-08-20

DAC_R | R - PLUG

Board | Board1 | Page | P1
Drawn | | Arduino Mega-Tlc-DFPlayer
Reviewed

DAC_L | L - PLUG

GND | GND

Version | Size | Page 1 Total 1
V1.0 | A4 | EasyEDA.com
