tait-mx/Constelacion/Electronica/Tlc5490NT/TLC_Arduino/ArduinoMega-Tlc-Conexion.pdf

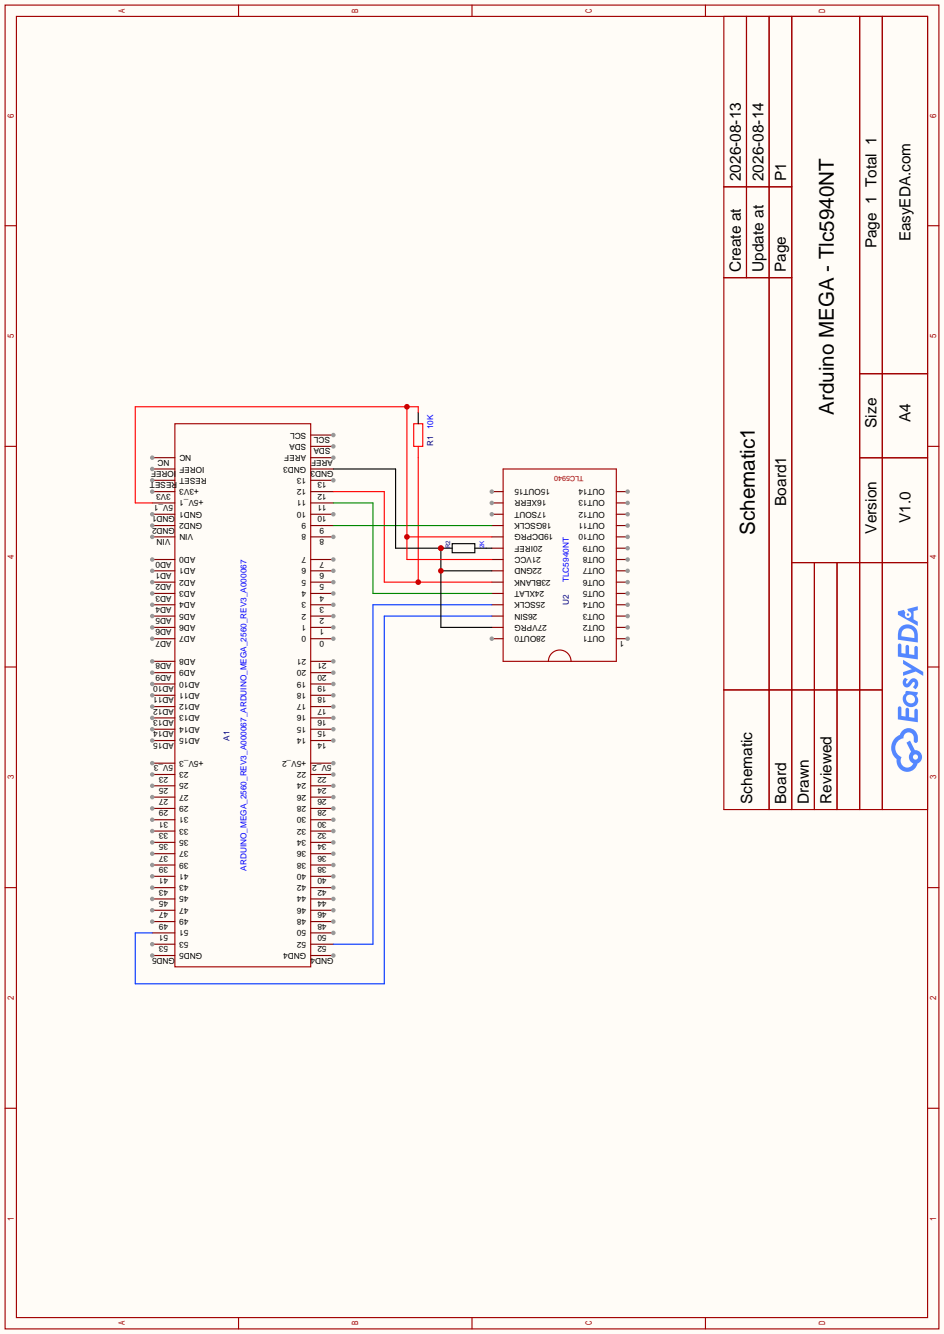
[picture p22: page 1]

V1.0 A4 EasyEDA.com NC NC IOREF IOREF RESET RESET +3V3 3V3 +5V_1 5V_1 GND1 GND1

Version Size Page 1 Total 1
