tait-mx/Constelacion/DFPlayer/DFPlayer_Mini_Constelacion_botones_INPUT_PULLUP_LCD_09ago2026.pdf

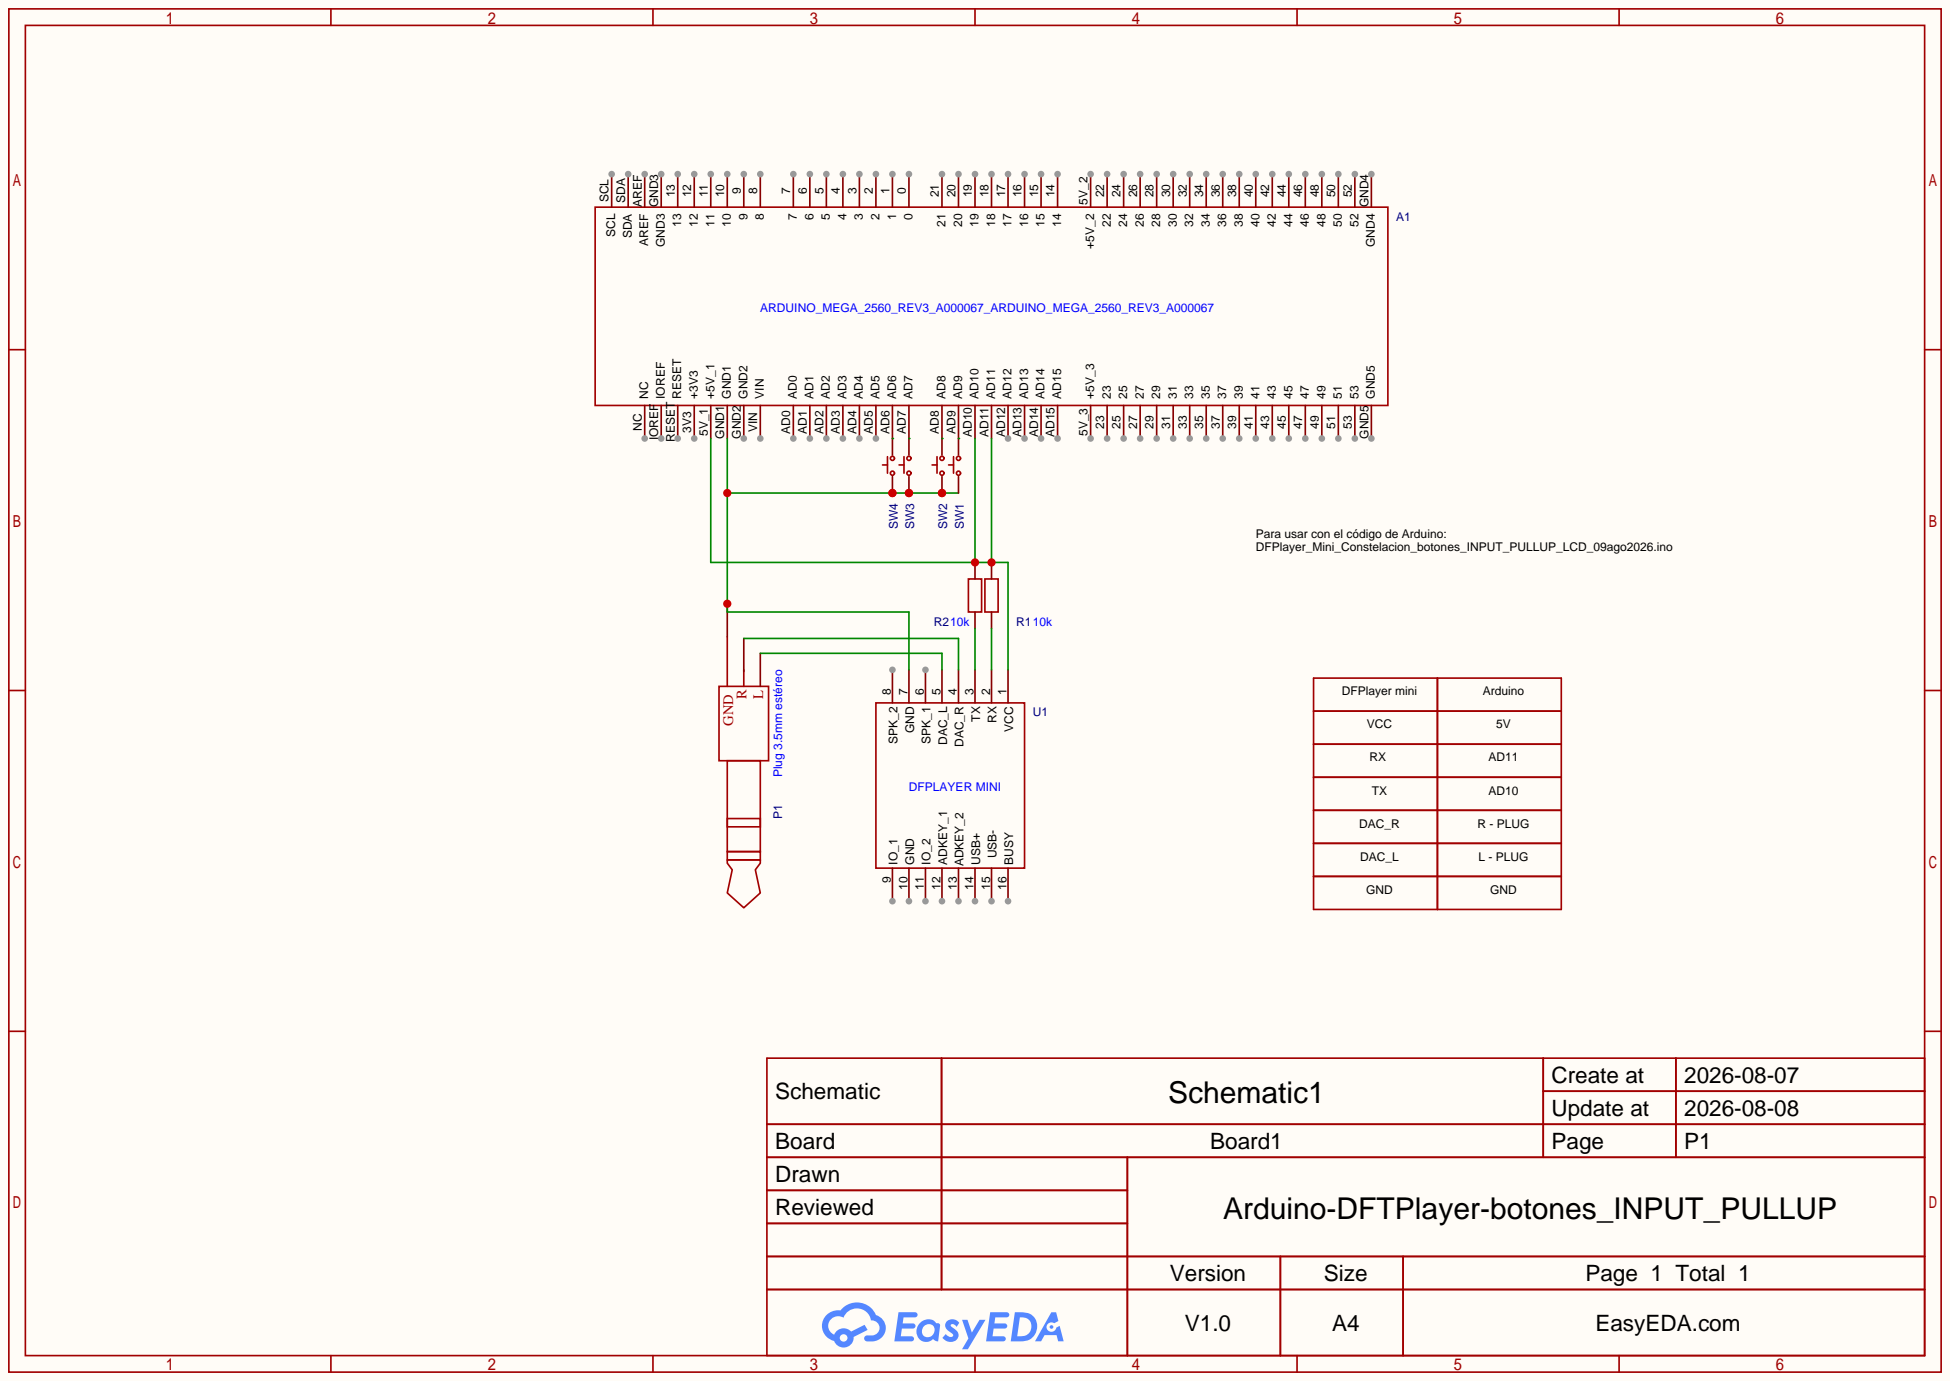
[picture p23: page 1]

Para usar con el código de Arduino:
DFPlayer_Mini_Constelacion_botones_INPUT_PULLUP_LCD_09ago2026.ino

DFPlayer mini | Arduino

VCC | 5V

DAC_R | R - PLUG

DAC_L | L - PLUG

GND | GND

Schematic | Schematic1 | Create at | 2026-08-07

Update at | 2026-08-08

Board | Board1 | Page | P1
Drawn | | Arduino-DFTPlayer-botones_INPUT_PULLUP
Reviewed

Version | Size | Page 1 Total 1
V1.0 | A4 | EasyEDA.com
