tait-mx/Constelacion/DFPlayer/Arduino-DFPlayer-Schematic.pdf

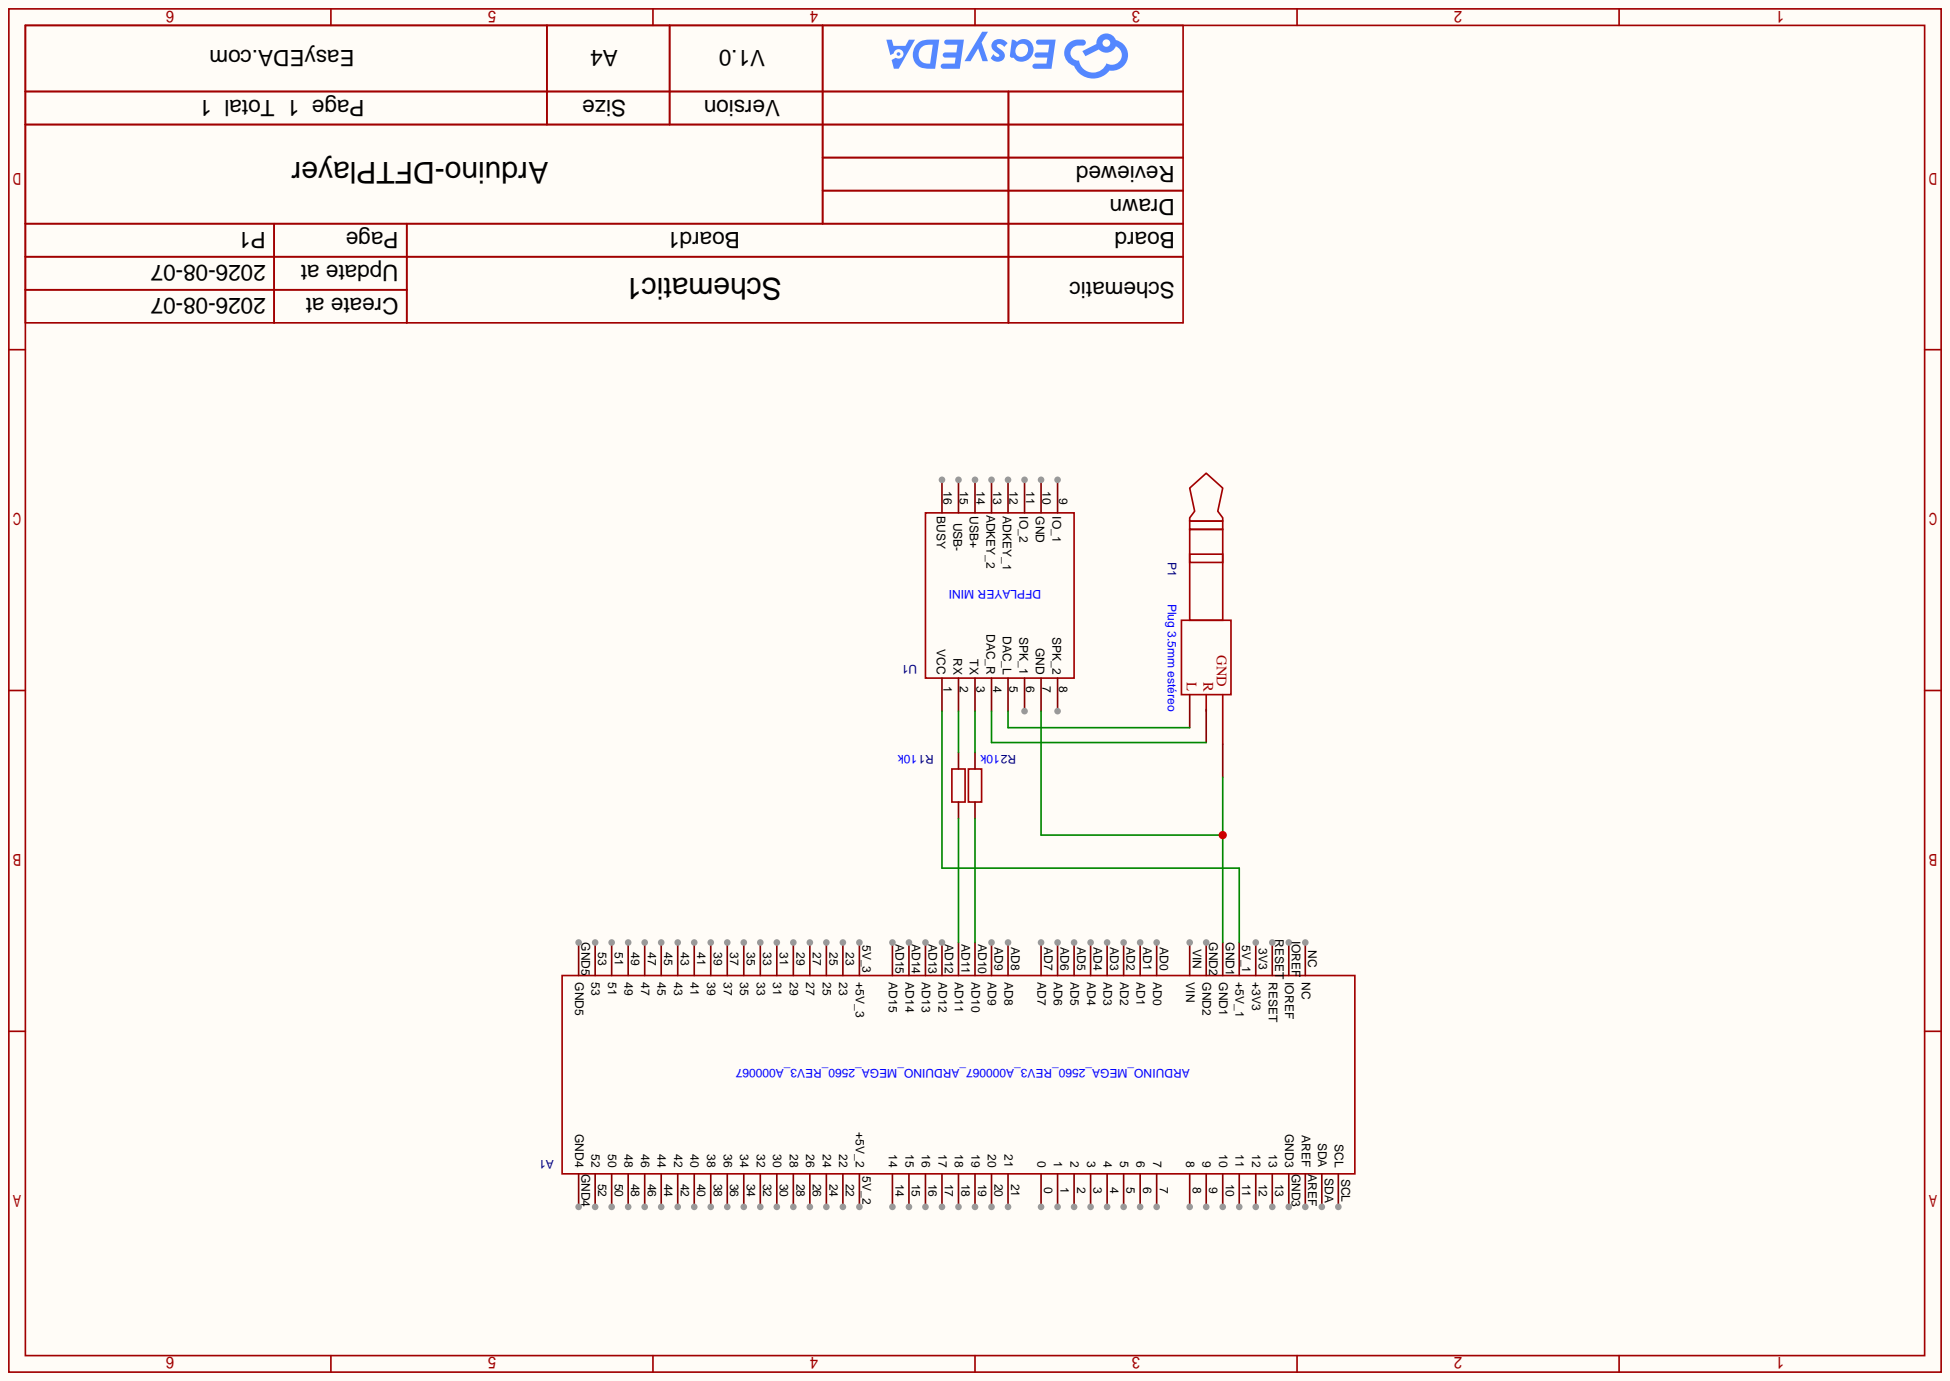
[picture p24: page 1]
