tait-mx/Constelacion/Electronica/LCD1602/Interfaz de LCD1602 con Arduino.pdf

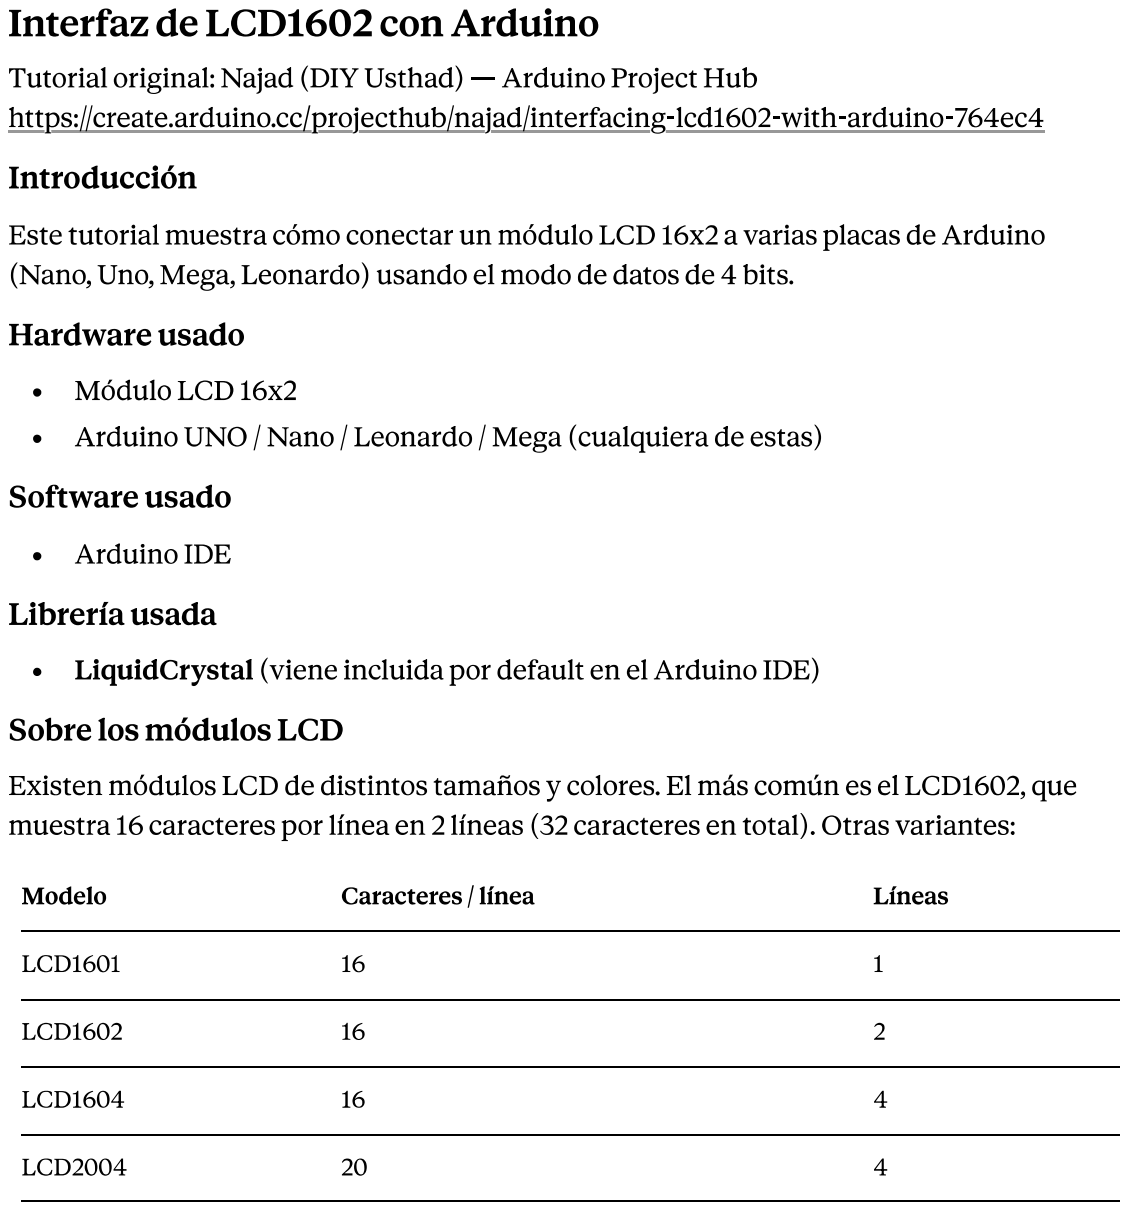
[picture p25: page 1]

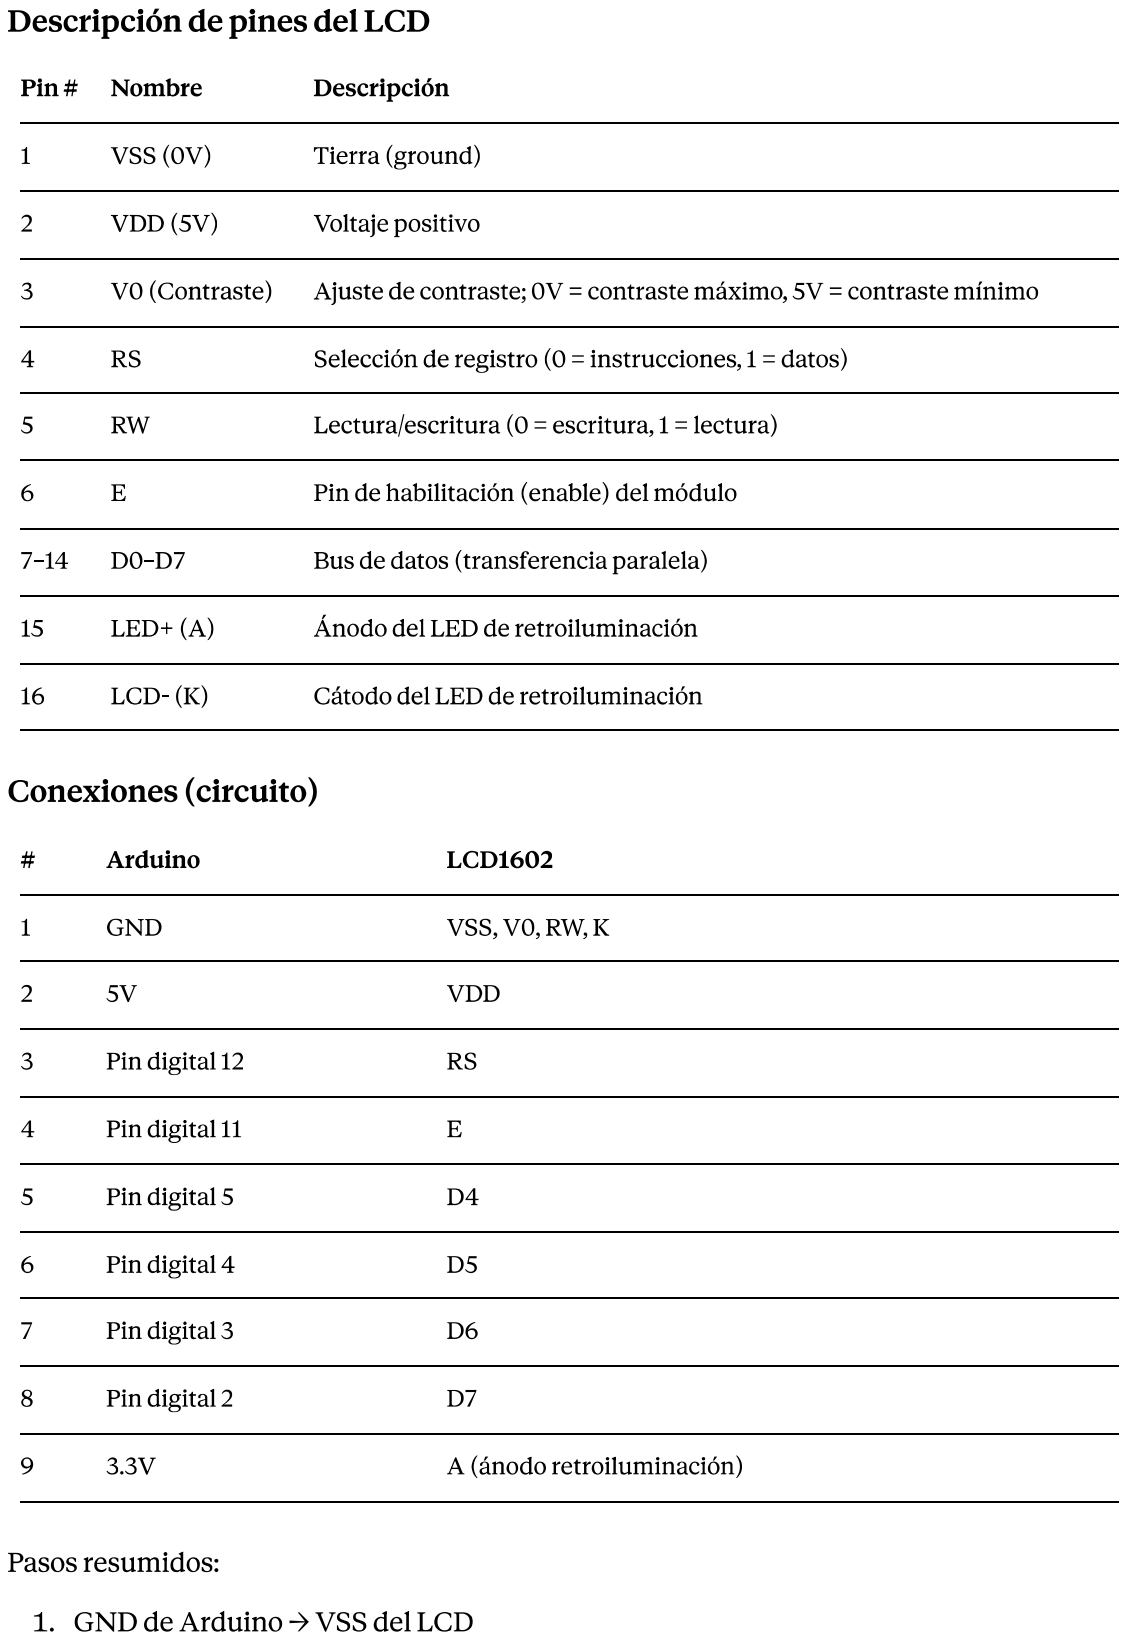
[picture p26: page 2]

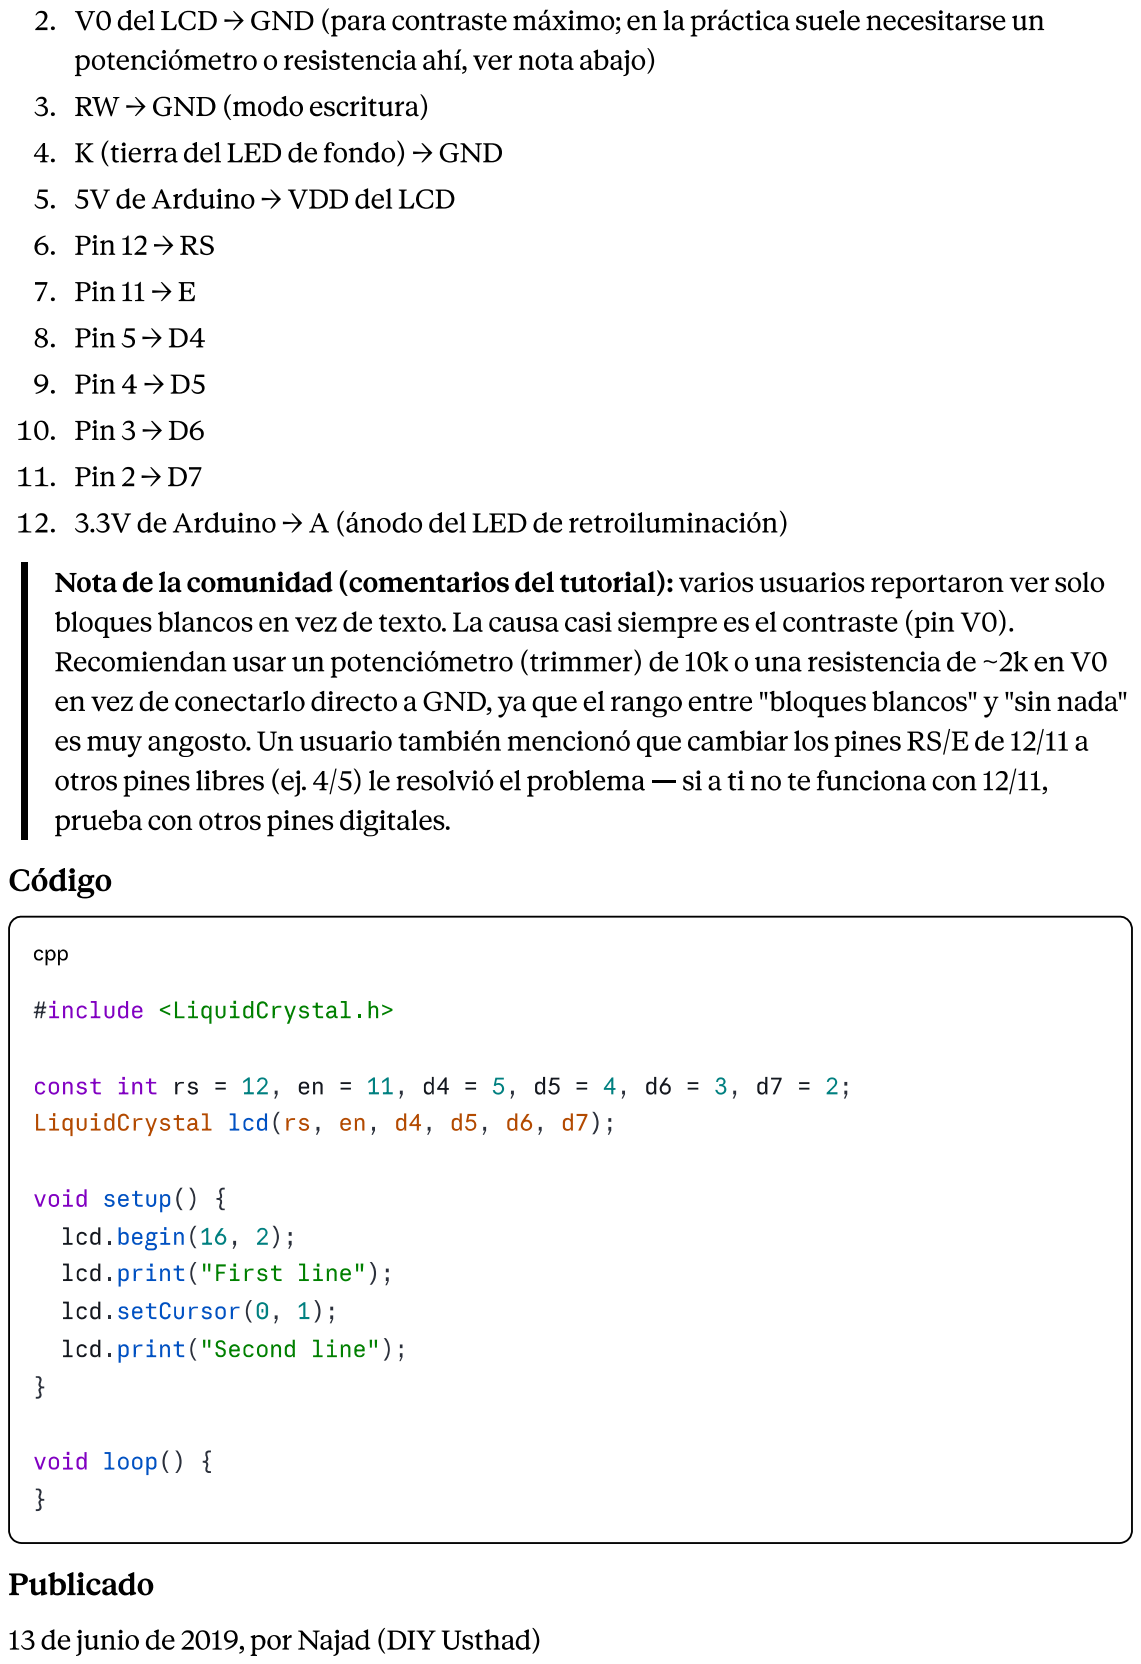
[picture p27: page 3]
