tait-mx/Constelacion/DFPlayer/DFPlayer_Mini/DFPlayer_Mini.ino

/*
 * myDFPlayer.begin(DFPlayerSerial)
 * myDFPlayer.volume(volume); 0-30
 * myDFPlayer.play();
 * myDFPlayer.play(5);  Reproduce el archivo 0005
 * myDFPlayer.next();
 * myDFPlayer.previous();
 * myDFPlayer.pause();
 * myDFPlayer.start();
 * myDFPlayer.randomAll();
 * myDFPlayer.enableLoop();
 * myDFPlayer.disableLoop();
 */


#include <SoftwareSerial.h>
#include "DFRobotDFPlayerMini.h"


const int BUTTON = 2;
const int threshold = 200;
volatile int lastTime = 0;
volatile bool nextSong = false;

SoftwareSerial DFPlayerSerial(10,11);   //Rx, Tx
DFRobotDFPlayerMini myDFPlayer;

void setup() {
  Serial.begin(9600);
  DFPlayerSerial.begin(9600);
  myDFPlayer.begin(DFPlayerSerial);
  myDFPlayer.volume(30);   //De 0 a 30
  //myDFPlayer.randomAll();

  pinMode(BUTTON, INPUT);
  attachInterrupt(digitalPinToInterrupt(BUTTON), buttonPressed, RISING);
  myDFPlayer.play();
  
}

void loop() {

if (myDFPlayer.available()) {
    printDetail(myDFPlayer.readType(), myDFPlayer.read());
  }

  /*
  if(nextSong == true){
    //myDFPlayer.next();
    //myDFPlayer.enableLoopAll();
    //myDFPlayer.enableLoop();
    myDFPlayer.randomAll();
    nextSong = false;
  }
  
 */
 delay(3000);
  
}

void buttonPressed(){
  if((millis() - lastTime) > threshold){
    nextSong = true;
    lastTime = millis();
  }
}


void printDetail(uint8_t type, int value){
  switch (type) {
    case TimeOut:
      Serial.println(F("Time Out!"));
      break;
    case WrongStack:
      Serial.println(F("Stack Wrong!"));
      break;
    case DFPlayerCardInserted:
      Serial.println(F("Card Inserted!"));
      break;
    case DFPlayerCardRemoved:
      Serial.println(F("Card Removed!"));
      break;
    case DFPlayerCardOnline:
      Serial.println(F("Card Online!"));
      break;
    case DFPlayerUSBInserted:
      Serial.println("USB Inserted!");
      break;
    case DFPlayerUSBRemoved:
      Serial.println("USB Removed!");
      break;
    case DFPlayerPlayFinished:
      Serial.print(F("Number:"));
      Serial.print(value);
      Serial.println(F(" Play Finished!"));
      myDFPlayer.next();
      break;
    case DFPlayerError:
      Serial.print(F("DFPlayerError:"));
      switch (value) {
        case Busy:
          Serial.println(F("Card not found"));
          break;
        case Sleeping:
          Serial.println(F("Sleeping"));
          break;
        case SerialWrongStack:
          Serial.println(F("Get Wrong Stack"));
          break;
        case CheckSumNotMatch:
          Serial.println(F("Check Sum Not Match"));
          break;
        case FileIndexOut:
          Serial.println(F("File Index Out of Bound"));
          break;
        case FileMismatch:
          Serial.println(F("Cannot Find File"));
          break;
        case Advertise:
          Serial.println(F("In Advertise"));
          break;
        default:
          break;
      }
      break;
    default:
      break;
  }
  
}
