tait-mx/Constelacion/ESP32/Blink-ESP32-super-mini/Blink-ESP32-super-mini.ino

int led = 8;
int delayTime = 250;

// the setup function runs once when you press reset or power the board
void setup() {
  // initialize digital pin LED_BUILTIN as an output.
  pinMode(led, OUTPUT);
}

// the loop function runs over and over again forever
void loop() {
  digitalWrite(led, HIGH);   // turn the LED on (HIGH is the voltage level)
  delay(delayTime);                       // wait for a second
  digitalWrite(led, LOW);    // turn the LED off by making the voltage LOW
  delay(delayTime);                       // wait for a second
}
