tait-mx/Constelacion/(commit log)

2026-08-03 Add Arduino libraries folder and delete Electronica.zip
2026-08-14 Add squematics and create code
    New squematics:
    Arduino-DFPlayer-Schematic.pdf
    DFPlayer_Mini_Constelacion_botones_INPUT_PULLUP_LCD_09ago2026.pdf
    Code:
    Implementation for push buttons instead of switches
    This one uses push buttons
    DFPlayer_Mini_Constelacion_push-botones_INPUT_PULLUP.ino
    This one uses switches
    DFPlayer_Mini_Constelacion_botones_INPUT_PULLUP.ino
2026-08-15 Add combined TLC villancico sequencer with DFPlayer button control
2026-08-17 Refresh TLC5940 PWM every loop cycle to keep LEDs lit
2026-08-21 Add debounce, Arduino-Tlc-DFPlayer Schematic
    Actual code
    /Users/ernestoromero/Documents/Constelacion/Constelacion-Tlc-DFPlayer-Villancicos-Debounce/Constelacion-Tlc-DFPlayer-Villancicos-Debounce.ino
    Added debounce to the code to avoid bouncing buttons noise.
    Made schematic of Arduino Mega 1280, Tlc5490NT and DFPlayer mini conections
    [Constelacion-Tlc-DFPlayer-Villancicos-Debounce.ino]
2026-08-25 Fix setup. Display villancico name in LCD
    Moved lcd.begin(16, 2); ot ouf the for() {} in thev setup() section to
    avoid unnecessary iterarions
    The villancico currently playing or ready to be played displays in the
    LCD
    [Constelacion-Tlc-DFPlayer-Villancicos-LCD-names.ino]
2026-08-26 Modify Rew and Fwd buttons
    if the mp3 device is playing
    button3 pressed goes to previous track and plays it
    button4 pressed goes to next track and plays it
    if the mp3 is not playing
    button3 pressed goes to previous track but doesn´t play
    button4 pressed goes to next track but doesn´t play
    In any case the villancico name must be displayed in the LCD
    Here's the change — I'll track play state with the existing stopped flag and branch button 3/4 behavior on it.
    1. Update the header comment (documentation only):
    cpp
    bot3 (pin 24) = REWIND -> previous track. Plays it if already playing; otherwise just selects it.
    bot4 (pin 25) = FORWARD-> next track. Plays it if already playin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
    [Constelacion-All-Devices-Rew-Fwd-behaviour.ino]
2026-08-26 Display "La Constelación" while the intro is running
    void showIntroOnLCD() {
    lcd.clear();
    lcd.setCursor(0, 0);
    lcd.print("La Constelacion");
    }
    Call it right before the intro runs, then show the song after:
    void setup() {
    Tlc.init();
    for (int i = 22; i <= 25; i++) {
    pinMode(i, INPUT_PULLUP);
    }
    lcd.begin(16, 2);
    Serial.begin(9600);
    DFPlayerSerial.begin(9600);
    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
    [Constelacion-Intro-LCD.ino]
2026-08-27 Add 3th villancico. Put gap between note sequences
    Added notasJoyToTheWorld / dursJoyToTheWorld arrays.
    Added it as the 3rd entry in songs[] with LCD name "Joy to the" / "World".
    Bumped noTracks from 2 to 3 — REWIND/FORWARD now cycle through all three
    tracks (% noTracks).
    No other logic changes needed: trackMasUno will be 3 for this song, so
    make sure track 3 on your SD card / DFPlayer's mp3 folder is Joy to the
    World's audio file, following the same naming convention as tracks
    1 and 2.
    Naming convention:
    0001.mp3 // Noche de Paz
    0002.mp3 // Niño del Tambor
    0002.mp3 // Joy to the World
    Song songs[] = {
    {notasNocheDePaz, dursNocheDePaz,
    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
    [Presupuesto_Materiales_Sistema_LED.xlsx]
2026-08-29 Fix MIDI for Joy to the World
    [Constelacion-3-villancicos-gap.ino]
2026-08-29 Create schematic for Arduino-Tlc-DFPlayer-LCD1602
2026-09-06 Add ESP32 folder
    Put files with the steps to connect ESP32 and ESP32C3 (super mini)
    with the Arduino IDE and upload programs to them
    [Costo Materiales Constelacion inalambrica.xlsx]
2026-09-09 Add ESP32 Development, cost sheet, busines scope
    The project moves from Arduino to ESP32 to get wireless comunication
    from a master microcontroler to several star-like receivers.
    Master and receiver codes were made
    Developed an aproximated cost sheet and a busines scope including
    sale and rent options.
2026-09-10 Add ESP32-DFPlayer basic conection code
2026-09-14 Create button control code for DFPlayer-ESP32
    this is the code:
    /Users/ernestoromero/Documents/Constelacion/ESP32/DFPlayer/DFPlayer-ESP32-botones.ino/DFPlayer-ESP32-botones.ino.ino
2026-09-14 Fwd&Rew buttons don´t play if no track is playing
2026-09-20 Moved access point to TP-link router
    * Using a TP-link router as access point
    ESP32 access point was canceled
    All ESP32 (master and clients) connect to TP-link_Archer_AX11800
    ESP32 master got a static IP: "192.168.0.150"
    TP-link_Archer_AX11800 SSID and password info in file:
    /Constelacion/ESP32/Conexion-inalambrica-ESP32-ESP32C/TP-link-Access-Point/Router_tp-link_Archer_AX11800
    ESP32 Master code: /Constelacion/ESP32/Conexion-inalambrica-ESP32-ESP32C/TP-link-Access-Point/ESP32_maestro_4_CLIENTES_TP-link/ESP32_maestro_4_CLIENTES_TP-link.ino
    ESP32-C3 Client code: /Constelacion/ESP32/Conexion-inalambrica-ESP32-ESP32C/TP-link-Access-Point/ESP32C3_Cliente_Access_Point_TP-link/ESP32C3_Cliente_Acc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
2026-09-21 Create sequence code
    The new code can send an ON/OFF signal to each client on each cuarter
    note in sequence at 60bpm. So we finaly there are different signals to
    to different clients at different moments.
    The code for the clients is the same:
    Constelacion/ESP32/Conexion-inalambrica-ESP32-ESP32C/TP-link-Access-Point/ESP32C3_Cliente_Access_Point_TP-link/ESP32C3_Cliente_Access_Point_TP-link.ino
    The new master sequence code:
    Constelacion/ESP32/Conexion-inalambrica-ESP32-ESP32C/TP-link-Access-Point/maestro_secuencia/maestro_secuencia.ino
    Old master common pulse signal code changed name:
    Constelacion/ESP32/Conexion-inalambrica-ESP32-ESP32C/TP-link-Access-Point/maestro_pulso_comun/maestro_pulso_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
2026-09-23 Add a blink in master to see latency
    Each time the master sends to a client a command to turn on it's LED
    the master also turns on it's lED so you can see if there is a delay
2026-09-23 Client fixed IDs
    Each one of the four clients has an unique ID from 0 to 3.
    When a client connects with the master sends it's ID.
    So the master knows who will send the command to following the
    sequence of clients in the "melody array"
    Master code:
    'Constelacion/ESP32/Conexion-inalambrica-ESP32-ESP32C/TP-link-Access-Point/maestro_IDs_fijas/maestro_IDs_fijas.ino'
    Clients code (each client has it's own code with the specific ID):
    'Constelacion/ESP32/Conexion-inalambrica-ESP32-ESP32C/TP-link-Access-Point/clientes_ID_fijo/cliente_0_ID_fijo/cliente_0_ID_fijo.ino'
    'Constelacion/ESP32/Conexion-inalambrica-ESP32-ESP32C/TP-link-Access-Point/clientes_ID_fijo/cliente_1_ID_fijo/cliente_1_ID_fijo.ino'
    '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
    [cliente_0_ID_fijo.ino, cliente_1_ID_fijo.ino, cliente_2_ID_fijo.ino, cliente_3_ID_fijo.ino, maestro_IDs_fijas.ino, maestro_noSleep_noDelay.ino]
2026-09-25 Create BOM. Connect ESP32 with LCD1602_I2C
    *Made BOM (Bill of Materials) with purchased and unpurchased items.
    *Create code to scann I2C address:
    Constelacion/ESP32/untitled folder/I2C_addr_scan/I2C_addr_scan.ino
    0x27 is the address
    * Create code to test ESP32 and LCD1602_I2C communication:
    Constelacion/ESP32/untitled folder/LCD_I2C_Hola_ESP32/LCD_I2C_Hola_ESP32.ino
    Communication succeded
    [Constelacion_BOM.xlsx]
2026-09-27 Put Noche de Paz sequence in master code
    * New code has Noche de Paz sequence and an implementation for silences
    thru #define SILENCE 255
    * Changedcode maestro_IDs_fijas.ino name to maestro_IDs_fijas_seq_0-8.ino
    Paths:
    maestro_IDs_fijas.ino (does not exist anymore) was in
    ESP32/Conexion-inalambrica-ESP32-ESP32C/TP-link-Access-Point/maestro_IDs_fijas/maestro_IDs_fijas.ino
    maestro_IDs_fijas_seq_0-8.ino is in
    ESP32/Conexion-inalambrica-ESP32-ESP32C/TP-link-Access-Point/maestro_IDs_fijas_seq_0-8/maestro_IDs_fijas_seq_0-8.ino
2026-09-27 Add 3 villancicos sound+LED sinchronized control
    Create maestro_3_villancicos_dfplayer.ino code in which 3 sequences of
    villancicos are implemented.
    Add DFPlayer with 3 mp3 files sinchronized with the villancicos sequences
    and 4 buttons for
    Path:
    Constelacion/ESP32/Conexion-inalambrica-ESP32-ESP32C/TP-link-Access-Point/maestro_3_villancicos_dfplayer/maestro_3_villancicos_dfplayer.ino
2026-10-02 Sinchronize Client sequence-DFPlayer-LCD1602_I2C
    You can see the current villancico's name, press play and start the
    sinchronized mp3 track and light sequence
    Current working code:
    Constelacion/ESP32/Conexion-inalambrica-ESP32-ESP32C/TP-link-Access-Point/maestro_villancicos_Estrellas-DFPlayer-LCD/maestro_villancicos_Estrellas-DFPlayer-LCD.ino
2026-10-02 Add button to turn on/off Client 4
2026-10-30 Add to test each LED at a time
    Test code name is prueba_leds.ino
    Constelacion/ESP32/Conexion-inalambrica-ESP32-ESP32C/TP-link-Access-Point/prueba_leds/prueba_leds.ino'
    PREV - NEXT select LED from 0 to 7 cyclically
    PLAY turns on/off selected LED
2026-10-30 Integrate test and perform modes. Organize files
    * New code with a MODE button that switches between
    TEST MODE - test LEDs separatly with PREV, NEXT and PLAY buttons
    PERFORM MODE - Play songs with PLAY, PREV, NEXT and STOP
    * I created a Varios folder and put all previous versions in /Varios/Versiones
    and network related files in /Varios/Conexion_red
2026-11-01 Improve client 7 WiFi/TCP stability and add reset diagnostics
    Client: (just for client 7. Other clients must get actualized yet)
    - Use WiFi.disconnect() instead of disconnect(true) so the radio is not
    powered off on every reconnect.
    - Apply setSleep(false) and setTxPower(13dBm) after the WiFi connection
    is established, so they are not lost across reconnects.
    - Raise TCP connect timeout from 300 ms to 1500 ms to avoid half-open
    connections when a SYN is delayed.
    - Remove duplicate Serial.begin() and wait for USB CDC with a timeout.
    - Report reset reason (esp_reset_reason) and RSSI to the master in the
    identification line ("ID:n RST:<reason> RSSI:<dBm>"), since the native
    USB serial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
2026-11-06 Add loop 1, loop all. Remove word "MODE" in LCD
    The LCD displays only "PERFORM" and "TEST" in both modes.
    The word "MODE" has been removed.
    Button GPIO_26 has 3 functions when pressed repeatedly:
    The loop modes work only in PERFORMANCE mode
    Default state: loop off. LCD shows no loop state
    Pressed one time: loop 1. LCD displays "LOOP 1"
    Pressed a second time: loop all. LCD displays "LOOP ALL"
    Pressed a third time: no loop. LCD displays no loop information
2026-11-06 Add "CLIENT CONNECT" MODE
    The mode button (GPIO_25) now has a 3th mode "CLIENT CONNECT"
    that shows which clients are connected. In secuential order
    the connected clients numbers are displayed in the LCD second line.
    If a client is not conected a _ is left in place.
    if the mode button is pressed to go to a different mode the performance
    keeps running if it was running and the selected mode actions apply. So
    in TEST MODE you can test a client even if the song sequence is playing
